paulrbarnard/LandyGauge/static/images/CompD.jpeg

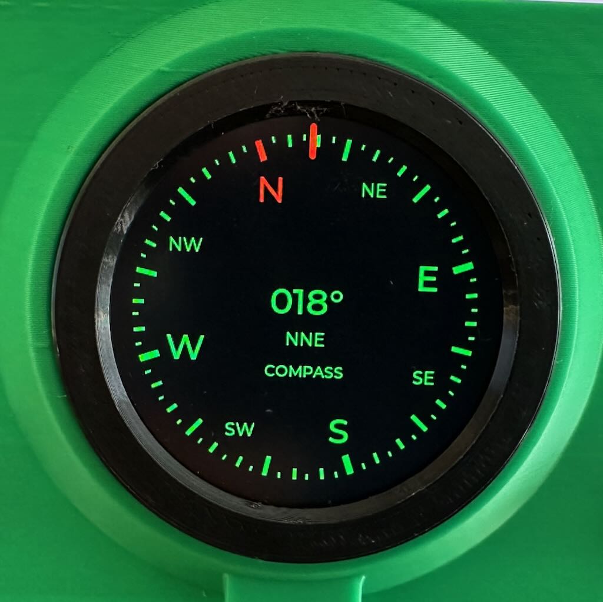
static/images/CompD.jpeg
