paulrbarnard/LandyGauge/static/images/Gauges.jpeg

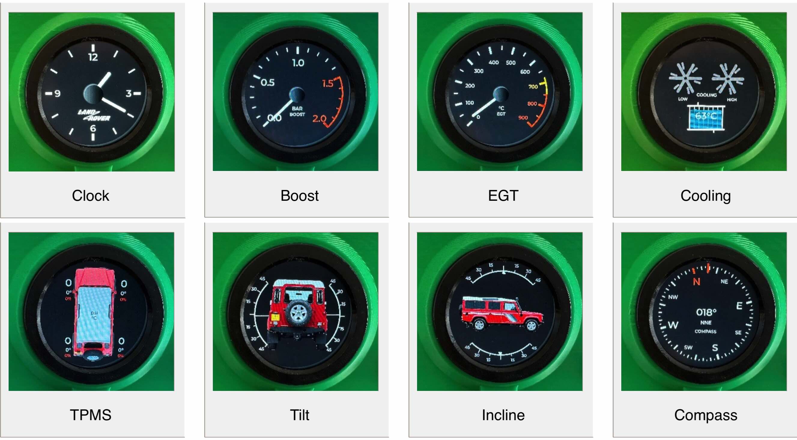
static/images/Gauges.jpeg
