paulrbarnard/LandyGauge/content/blog/_index.md

---
title: "Blog"
date: 2026-04-20
draft: false
ShowToc: false
---
