paulrbarnard/LandyGauge/static/images/Boost.jpeg

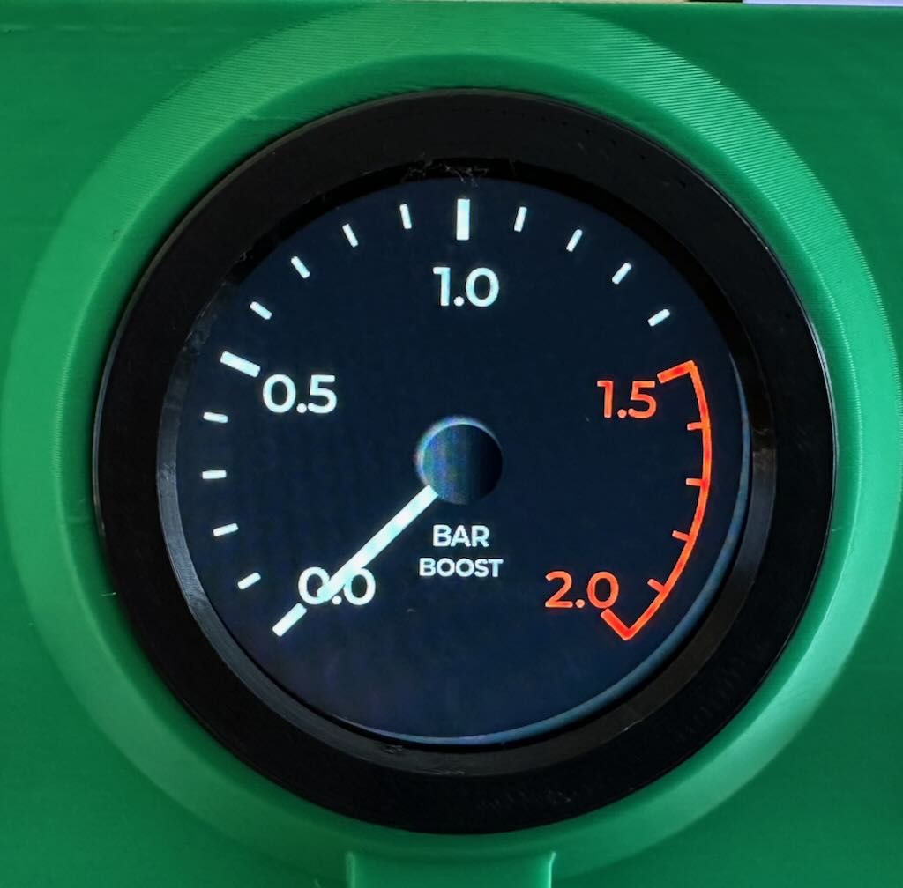
static/images/Boost.jpeg
