paulrbarnard/LandyGauge/static/images/BoostD.jpeg

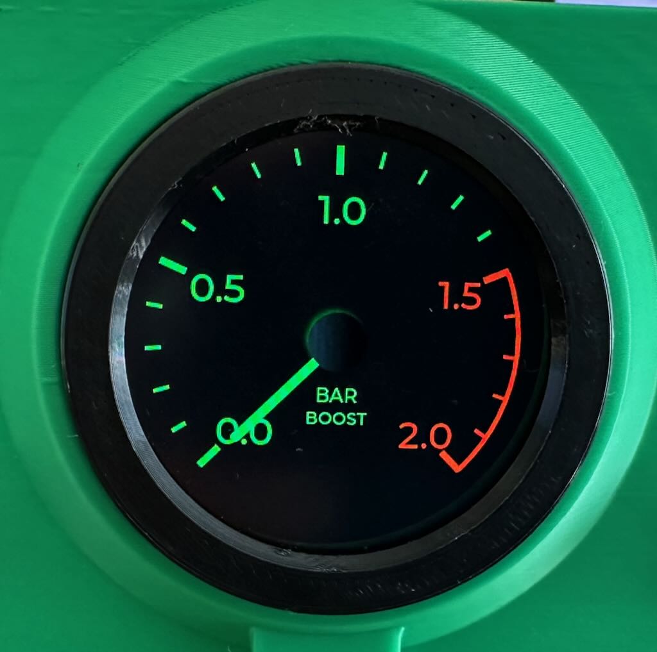
static/images/BoostD.jpeg
