paulrbarnard/LandyGauge/static/images/CAD.jpg

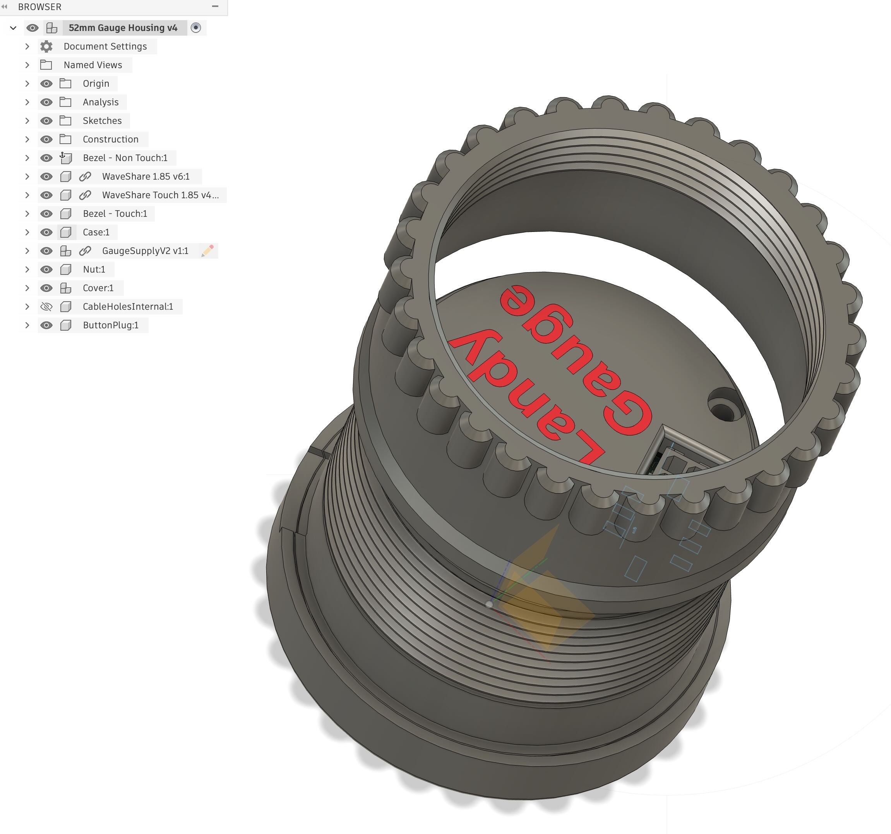
static/images/CAD.jpg
