paulrbarnard/LandyGauge/static/images/Clock.jpeg

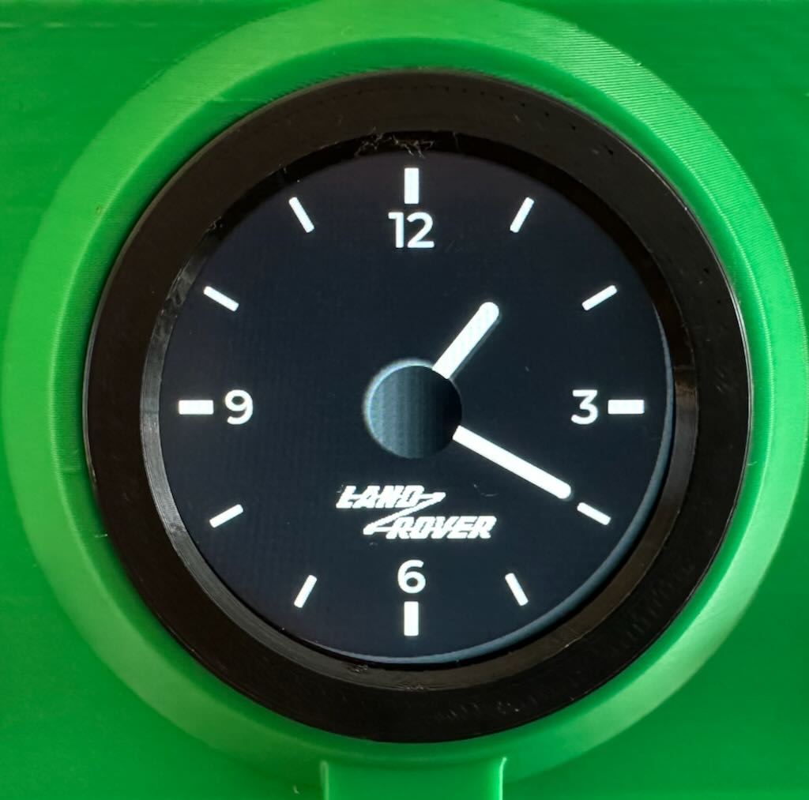
static/images/Clock.jpeg
