paulrbarnard/LandyGauge/static/images/ClockD.jpeg

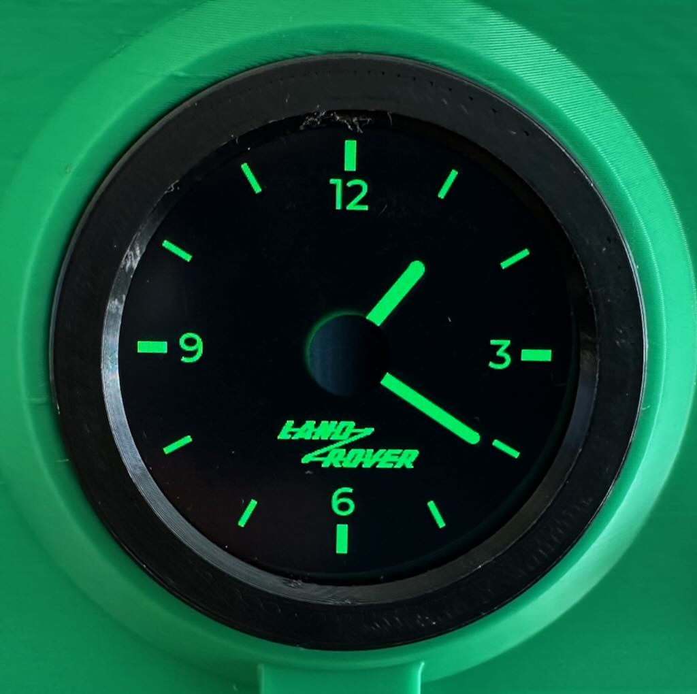
static/images/ClockD.jpeg
