paulrbarnard/LandyGauge/static/images/Comp.jpeg

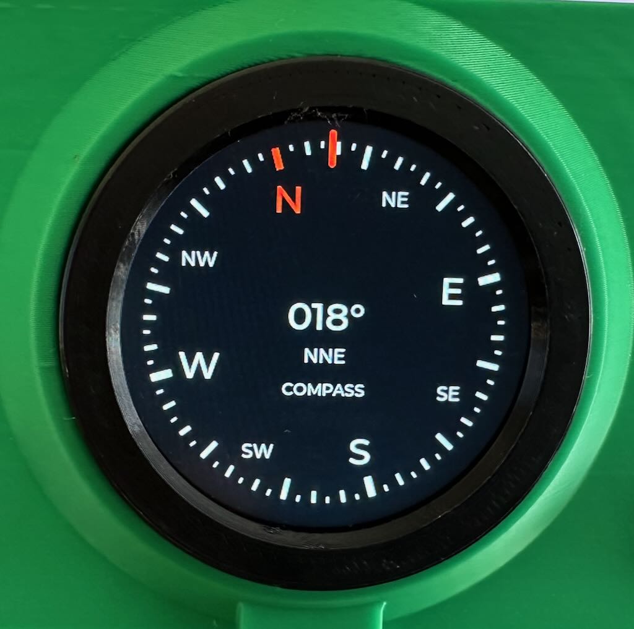
static/images/Comp.jpeg
