paulrbarnard/LandyGauge/static/images/Cool.jpeg

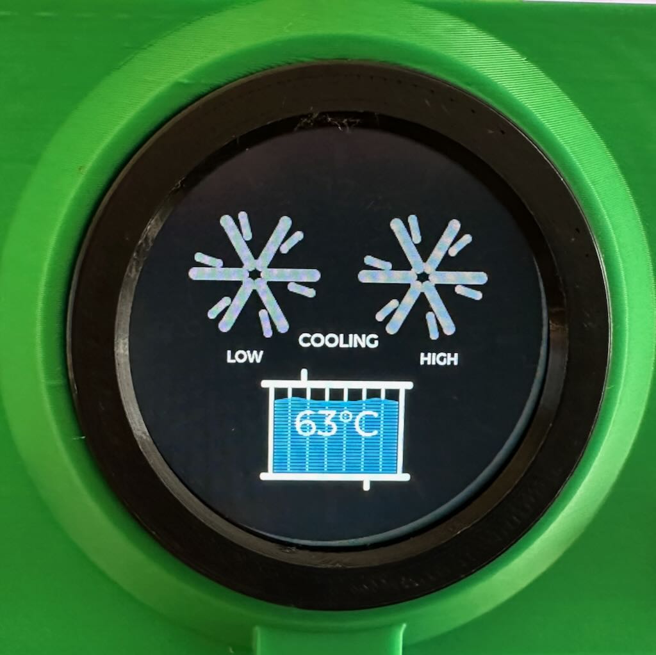
static/images/Cool.jpeg
