paulrbarnard/LandyGauge/static/images/CoolD.jpeg

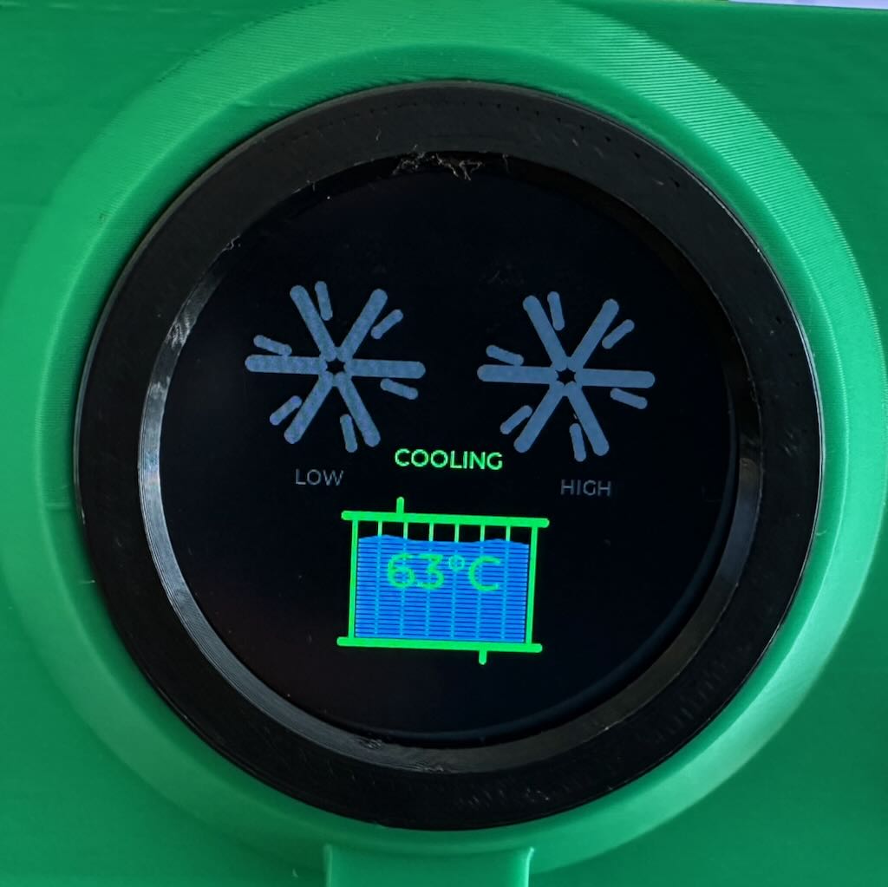
static/images/CoolD.jpeg
