paulrbarnard/LandyGauge/static/images/Dash.jpeg

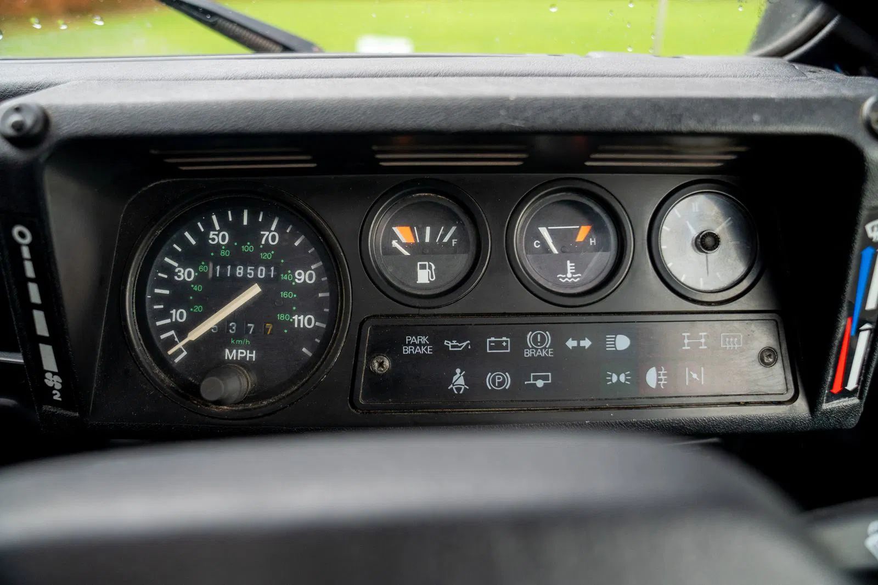
static/images/Dash.jpeg
