paulrbarnard/LandyGauge/static/images/EGT.jpeg

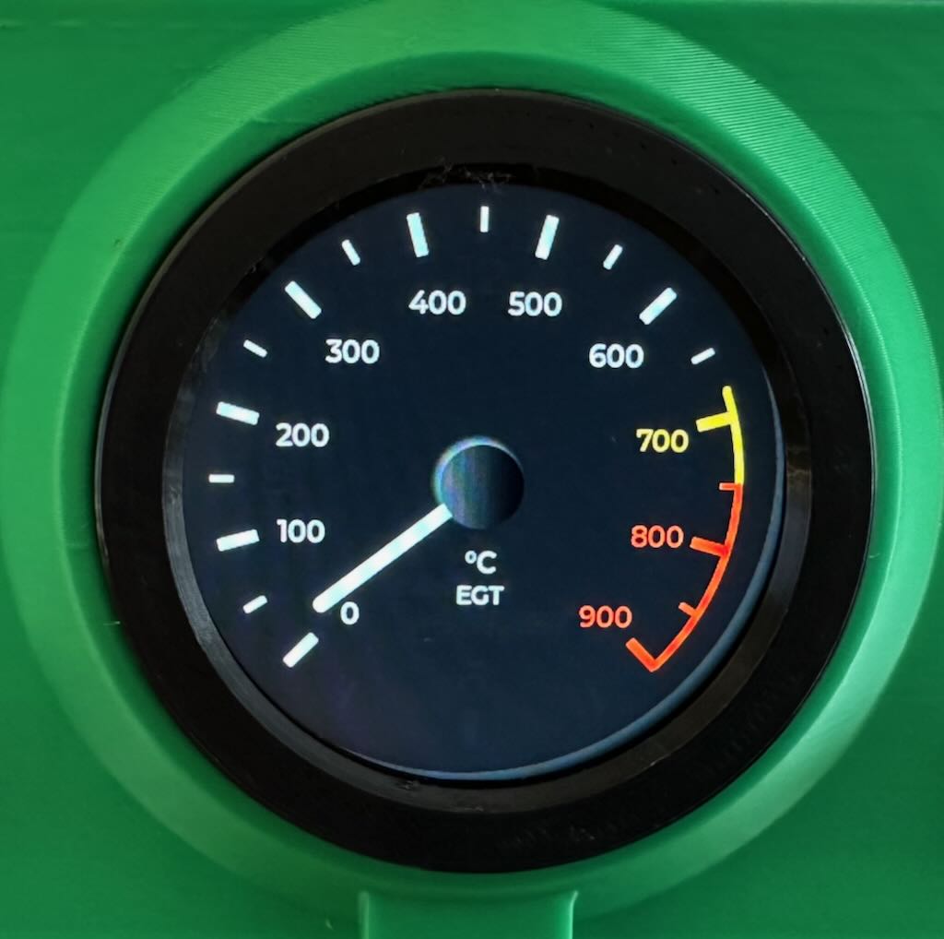
static/images/EGT.jpeg
