paulrbarnard/LandyGauge/static/images/EGTD.jpeg

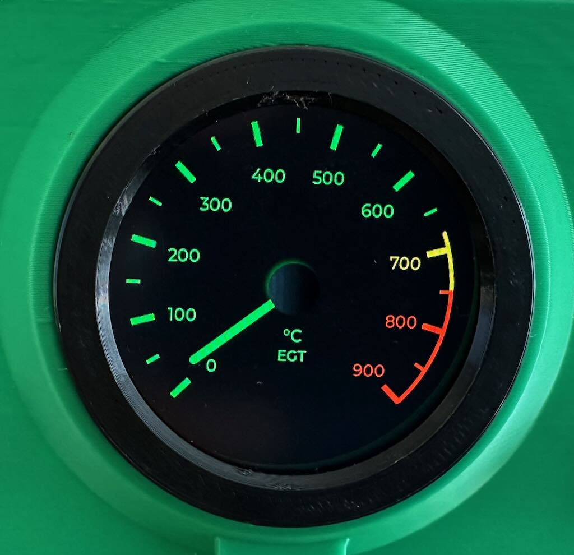
static/images/EGTD.jpeg
