paulrbarnard/LandyGauge/static/images/Incl.jpeg

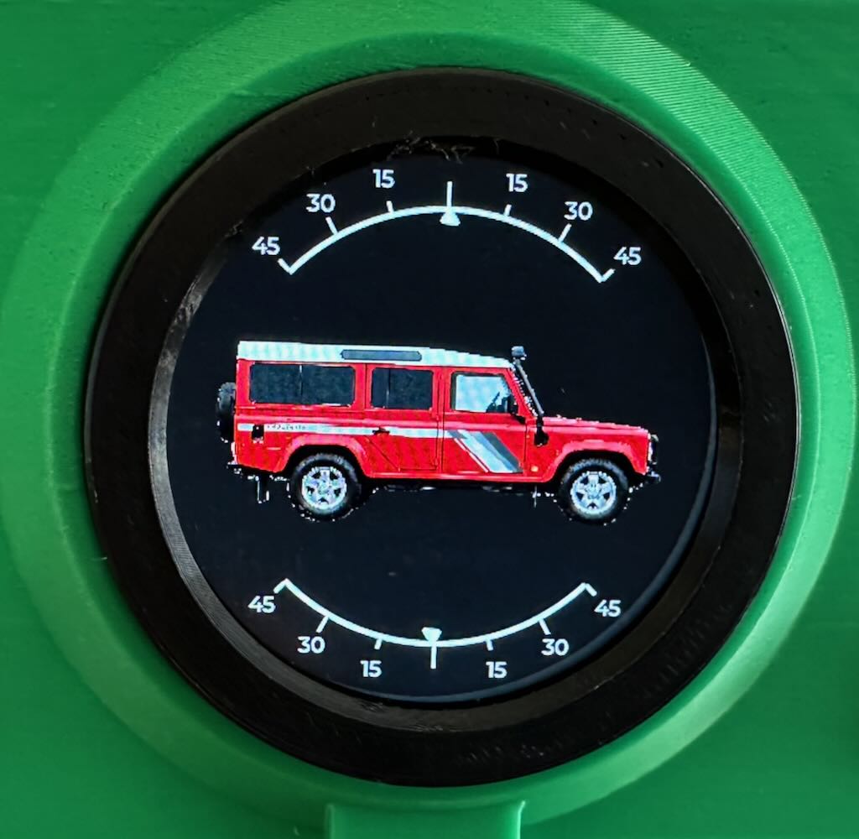
static/images/Incl.jpeg
