paulrbarnard/LandyGauge/static/images/InclD.jpeg

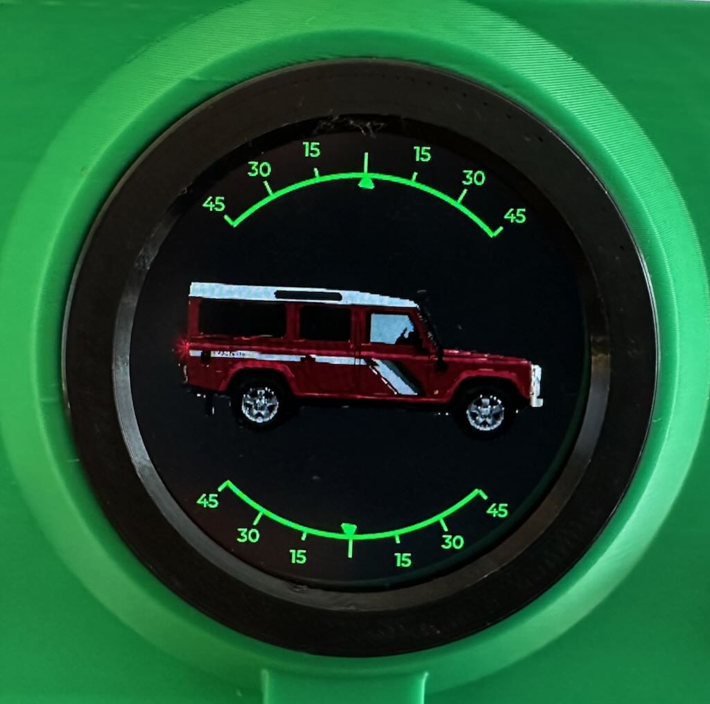
static/images/InclD.jpeg
