paulrbarnard/LandyGauge/static/images/LGCon.jpeg

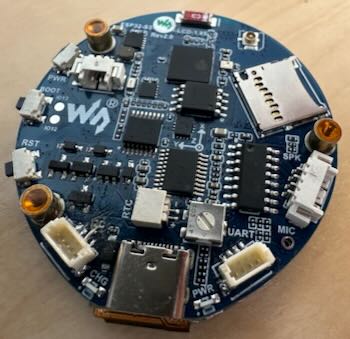
static/images/LGCon.jpeg
