paulrbarnard/LandyGauge/static/images/OrigClk.jpeg

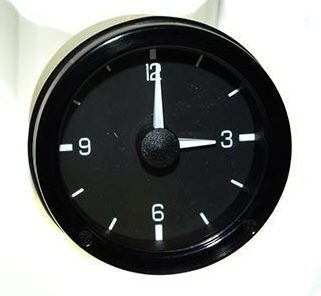
static/images/OrigClk.jpeg
