paulrbarnard/LandyGauge/static/images/RearView.jpeg

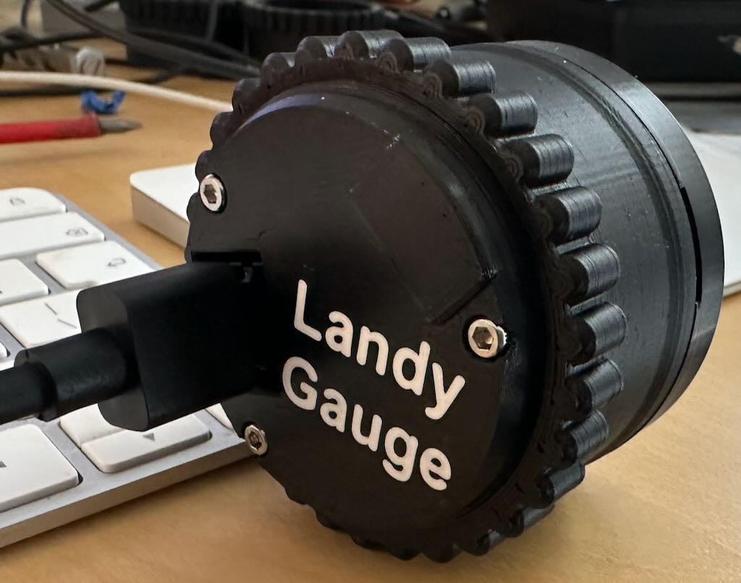
static/images/RearView.jpeg
