paulrbarnard/LandyGauge/static/images/Tilt.jpeg

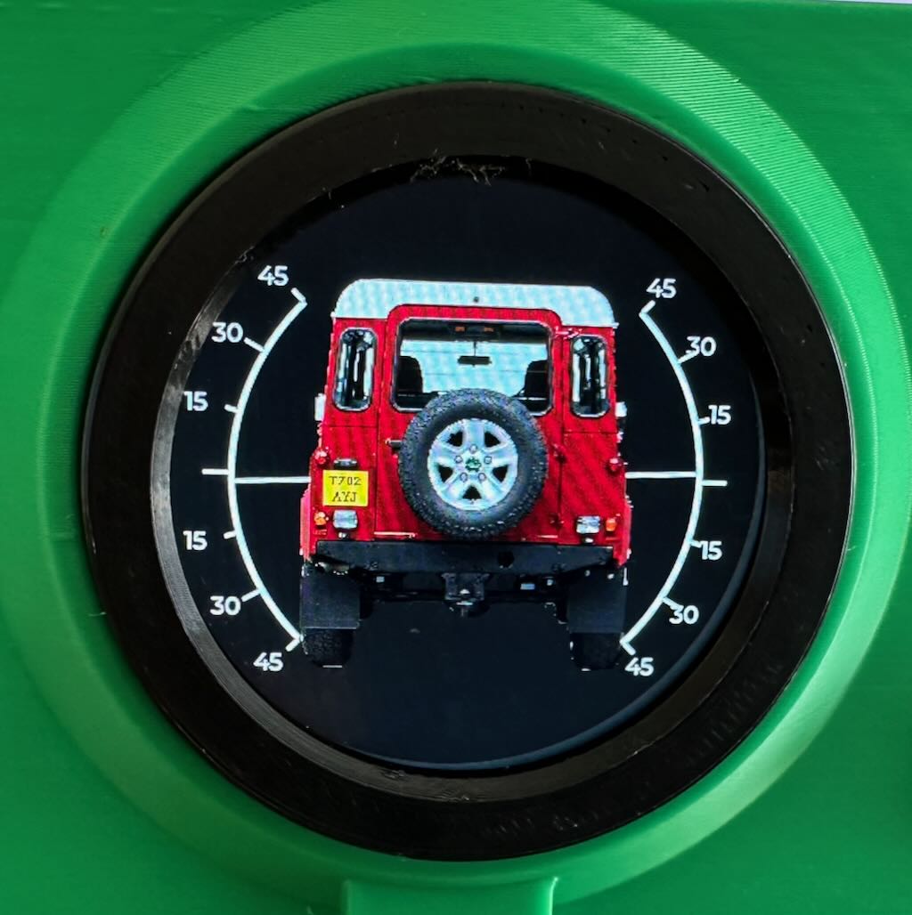
static/images/Tilt.jpeg
