paulrbarnard/LandyGauge/static/images/TiltD.jpeg

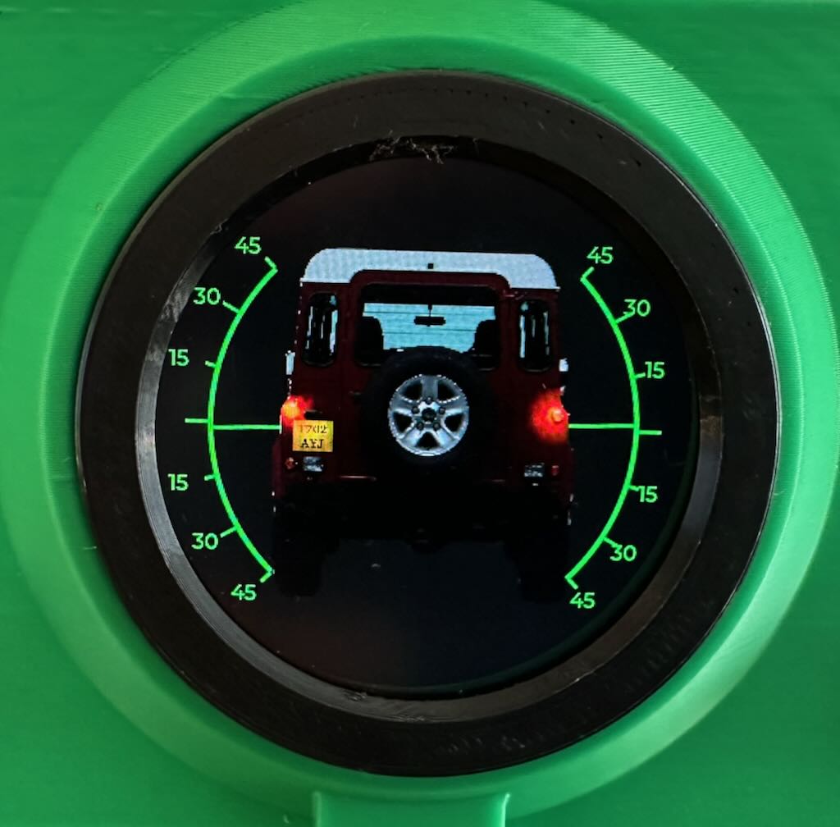
static/images/TiltD.jpeg
