paulrbarnard/LandyGauge/static/images/TPMS.jpeg

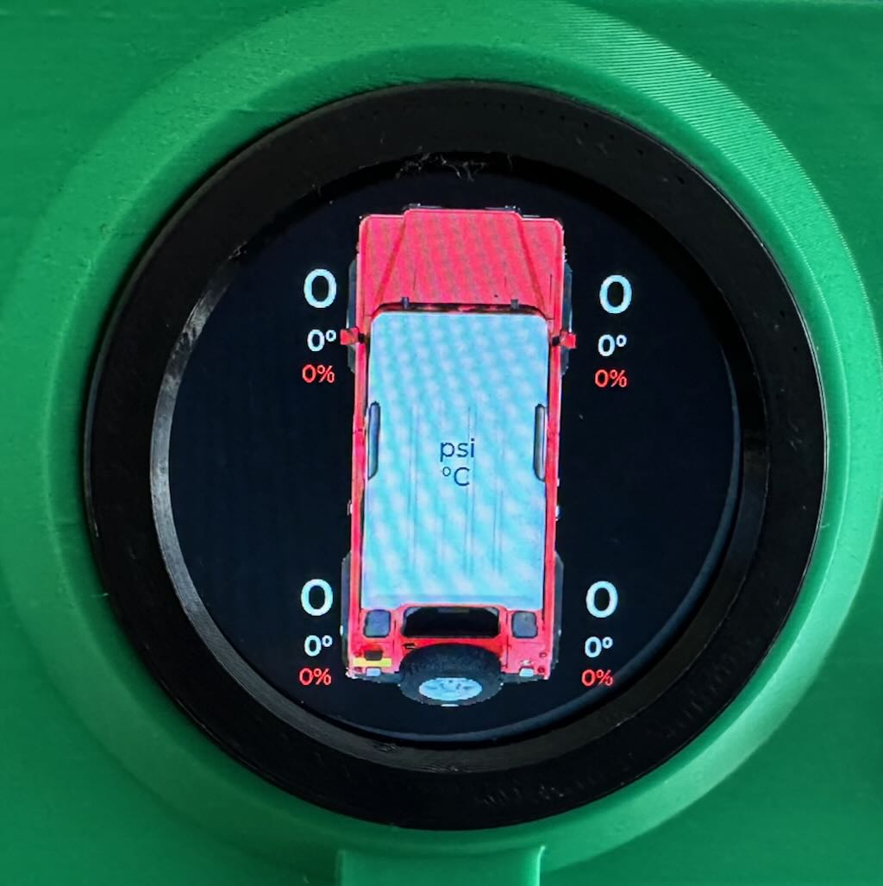
static/images/TPMS.jpeg
