paulrbarnard/LandyGauge/static/images/TPMSD.jpeg

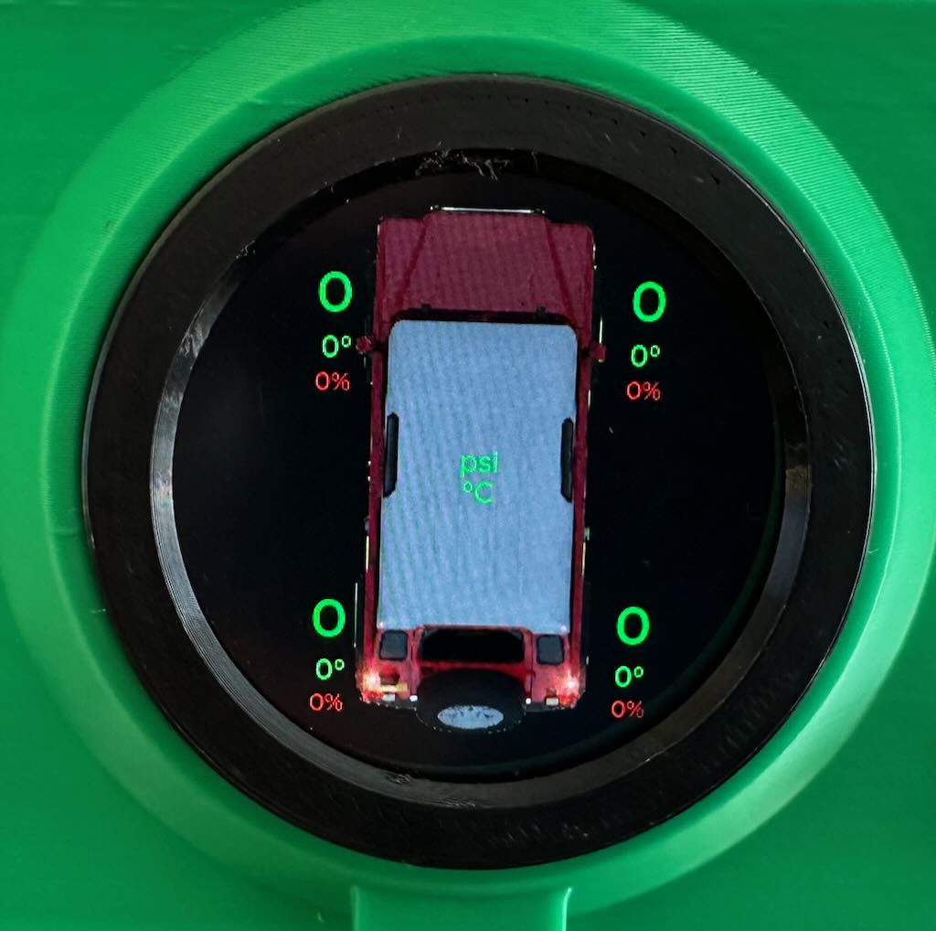
static/images/TPMSD.jpeg
