paulrbarnard/LandyGauge/static/images/WSCon.jpeg

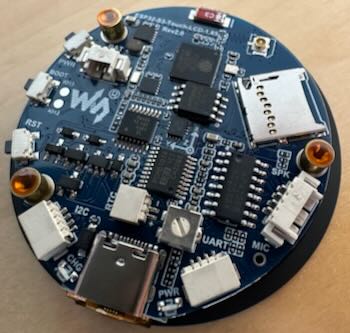
static/images/WSCon.jpeg
