paulrbarnard/LandyGauge/static/downloads/3d-models/expansion-box/BoardClamp.obj

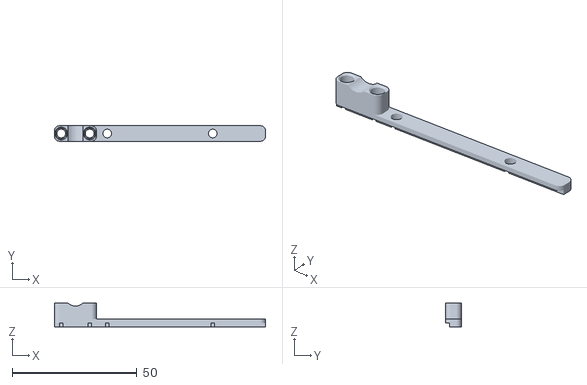
[picture p24: CAD file, 2026-04-22]
static/downloads/3d-models/expansion-box/BoardClamp.obj
84.5 x 6.25 x 9.60
