paulrbarnard/LandyGauge/static/downloads/3d-models/fan-relay-box-type1/gromit.obj

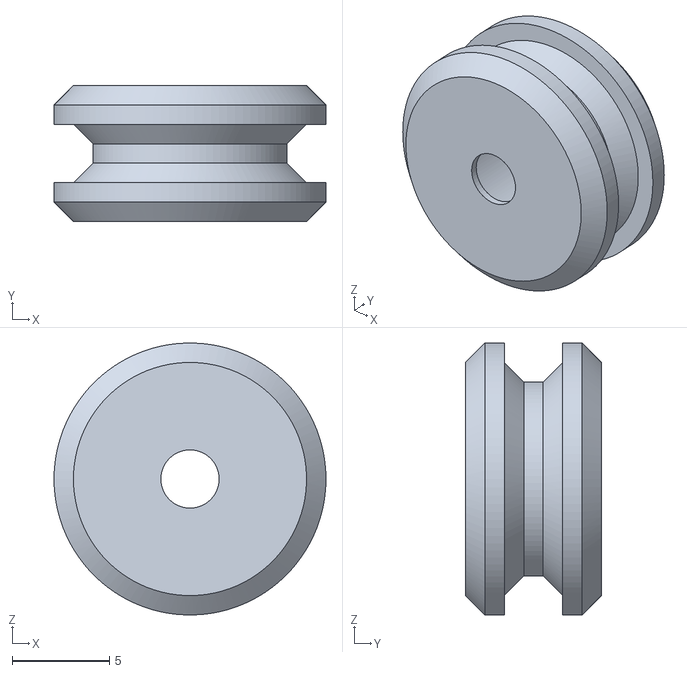
[picture p25: CAD file, 2026-04-22]
static/downloads/3d-models/fan-relay-box-type1/gromit.obj
14.0 x 7.00 x 14.0
