paulrbarnard/LandyGauge/static/downloads/3d-models/fan-relay-box-type2/Grommit.obj

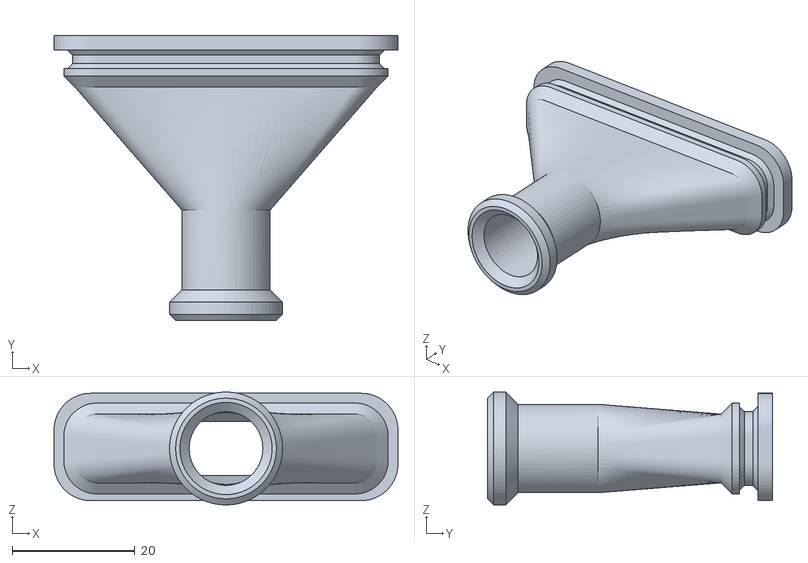
[picture p26: CAD file, 2026-04-22]
static/downloads/3d-models/fan-relay-box-type2/Grommit.obj
56.0 x 46.4 x 18.4
