paulrbarnard/LandyGauge/static/downloads/3d-models/gauge-housing/Cover.obj

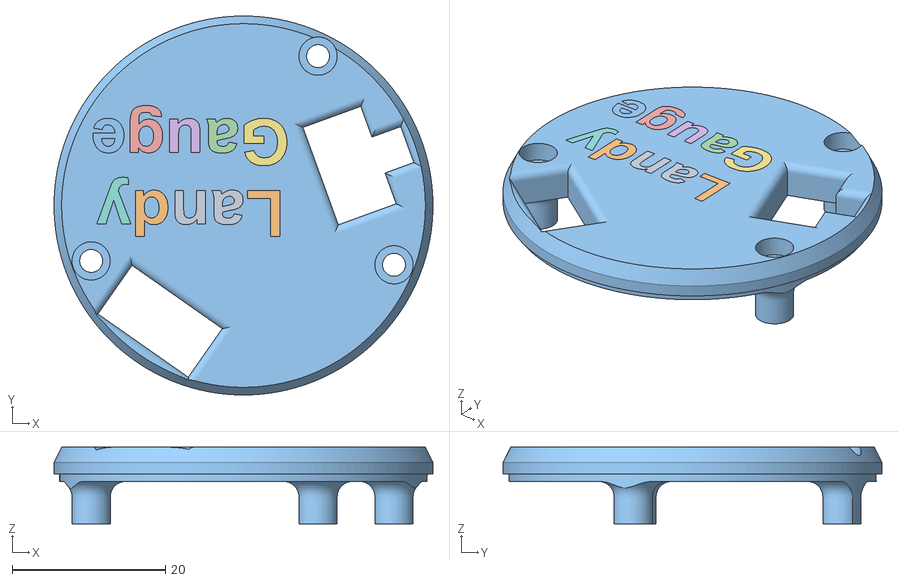
[picture p27: CAD file, 2026-04-20]
static/downloads/3d-models/gauge-housing/Cover.obj
49.5 x 49.5 x 10.1
Cap
