paulrbarnard/LandyGauge/static/downloads/pcb-fan-relay/LandyFan.step

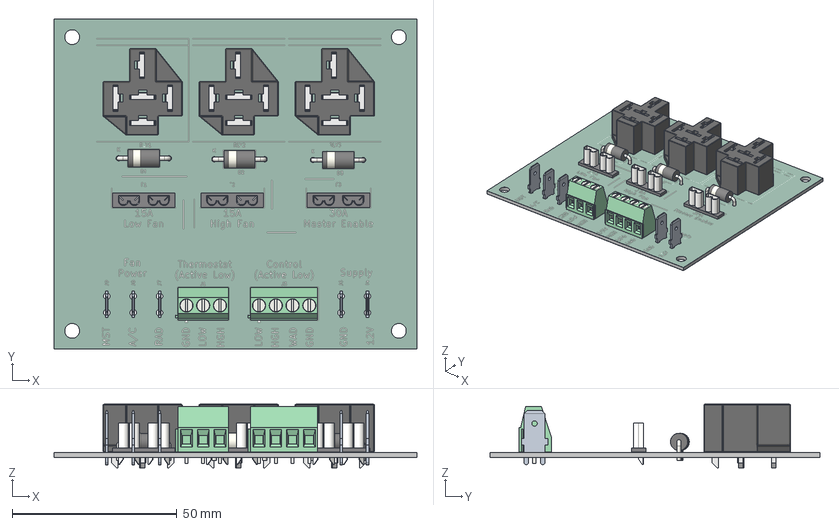
[picture p28: CAD file, 2026-04-20]
static/downloads/pcb-fan-relay/LandyFan.step
110.0 x 100.0 x 19.2 mm
Pins x 3
Spade x 5
pins x 3
TerminalBlock_Phoenix_MKDS-1,5-4-5.08_1x04_P5.08mm_Horizontal
TerminalBlock_Phoenix_MKDS-1,5-3-5.08_1x03_P5.08mm_Horizontal
D_DO-201AD_P15.24mm_Horizontal x 3
LandyFan_silkscreen
LandyFan_soldermask x 2
LandyFan_PCB
