paulrbarnard/LandyGauge/static/downloads/pcb-gauge-supply/GaugeSupply.step

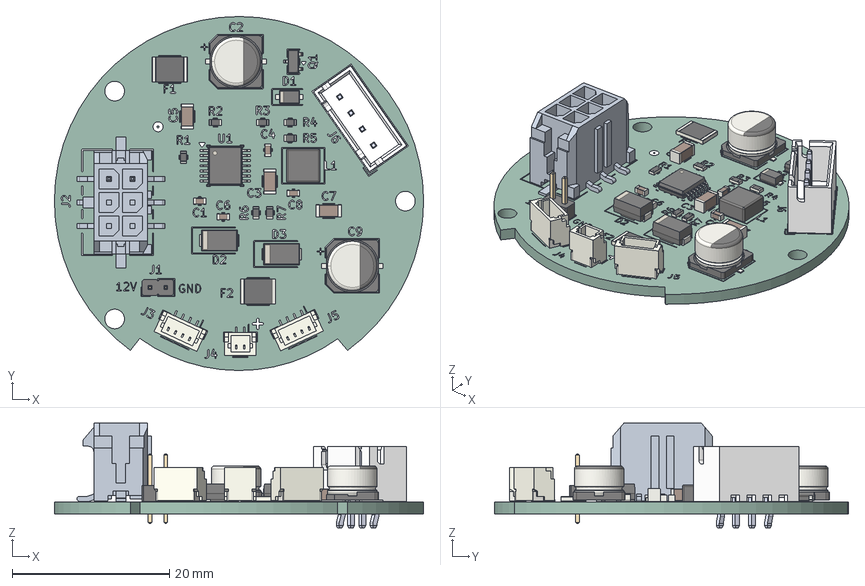
[picture p29: CAD file, 2026-04-20]
static/downloads/pcb-gauge-supply/GaugeSupply.step
47.0 x 45.1 x 13.4 mm
R_0603_1608Metric x 7
C_0603_1608Metric x 4
PinHeader_1x02_P2.00mm_Vertical
BxB-XH-A_04
R_1812_4532Metric x 2
D_SOD-123F
Texas_HTSSOP-14-1EP_4.4x5mm_P0.65mm_EP3.4x5mm_Mask3.155x3.255mm
CP_Elec_6.3x4.5 x 2
JST_SH_BM04B-SRSS-TB_1x04-1MP_P1.00mm_Vertical x 2
C_1206_3216Metric x 3
SOT-23
D_SMA x 2
L_Coilcraft_XAL4020-XXX
JST_SH_BM02B-SRSS-TB_1x02-1MP_P1.00mm_Vertical
GaugeSupply_silkscreen x 2
GaugeSupply_PCB
