paulrbarnard/LandyGauge/static/downloads/3d-models/expansion-box/lockTab.obj

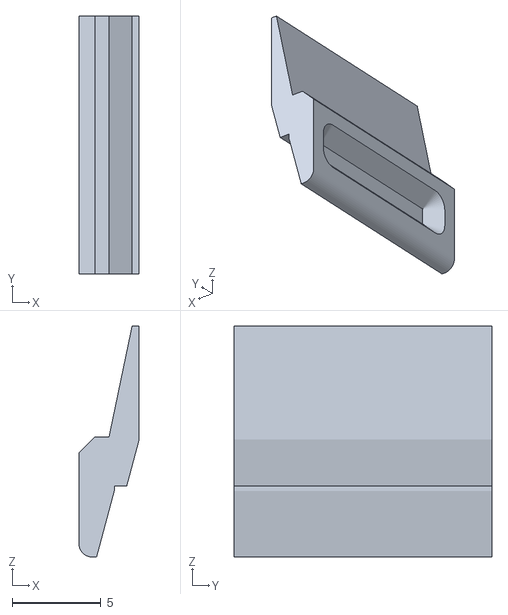
[picture p30: CAD file, 2026-04-22]
static/downloads/3d-models/expansion-box/lockTab.obj
3.40 x 14.5 x 13.0
