paulrbarnard/LandyGauge/static/downloads/3d-models/fan-relay-box-type1/lid.obj

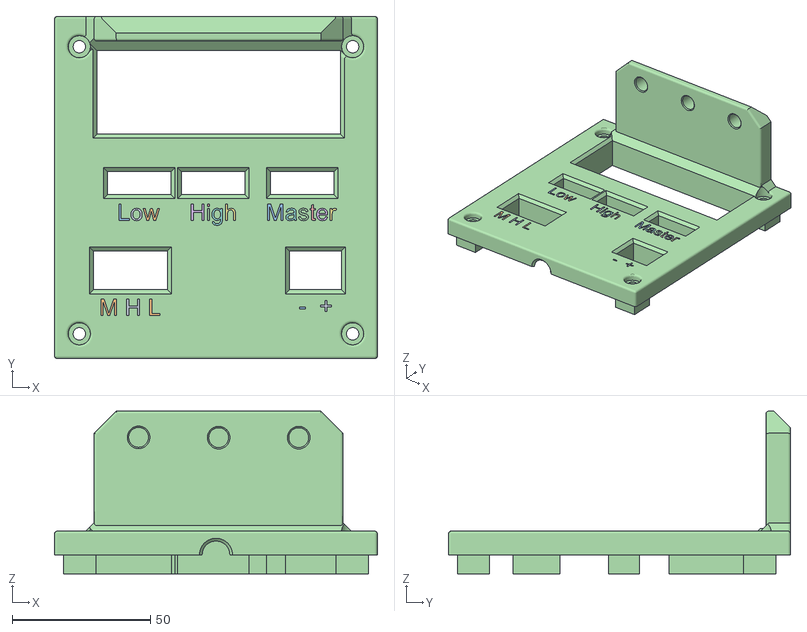
[picture p31: CAD file, 2026-04-22]
static/downloads/3d-models/fan-relay-box-type1/lid.obj
117.0 x 124.0 x 58.9
