paulrbarnard/LandyGauge/static/downloads/3d-models/fan-relay-box-type2/Base.obj

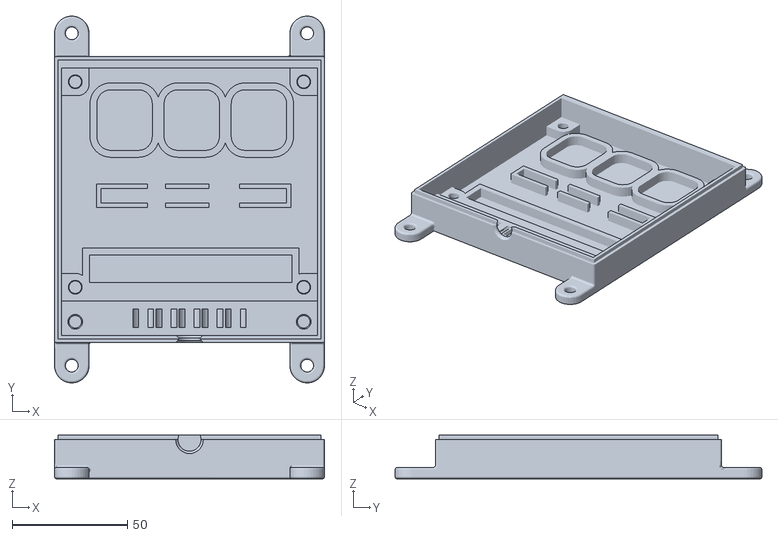
[picture p32: CAD file, 2026-04-22]
static/downloads/3d-models/fan-relay-box-type2/Base.obj
117.0 x 159.0 x 19.0
