paulrbarnard/LandyGauge/static/downloads/3d-models/expansion-box/lid.obj

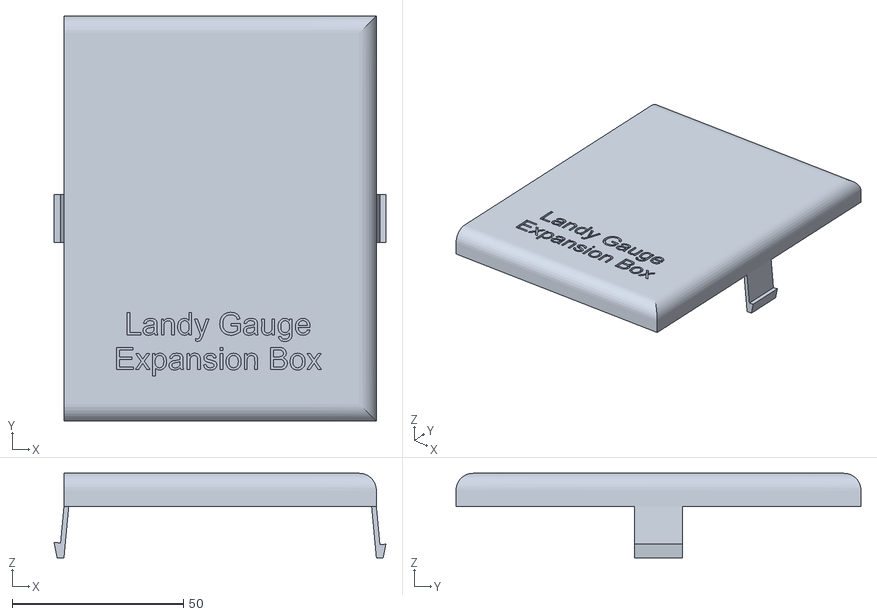
[picture p33: CAD file, 2026-04-22]
static/downloads/3d-models/expansion-box/lid.obj
96.8 x 118.1 x 24.6
