paulrbarnard/LandyGauge/static/downloads/3d-models/fan-relay-box-type2/Gaskit.obj

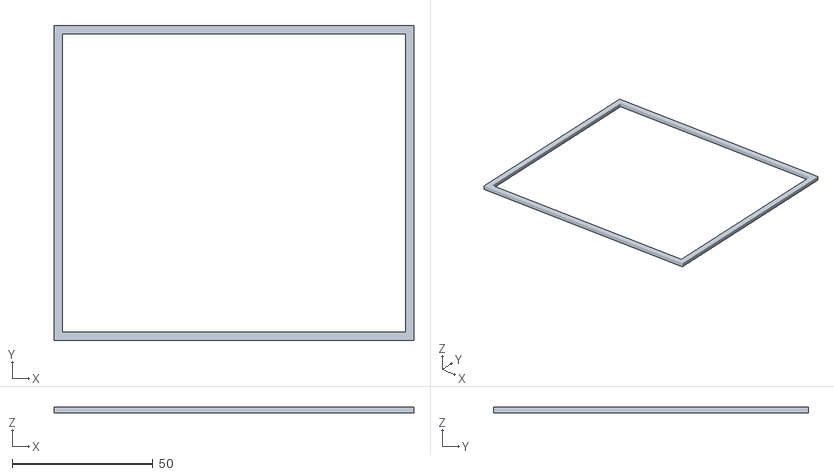
[picture p34: CAD file, 2026-04-22]
static/downloads/3d-models/fan-relay-box-type2/Gaskit.obj
128.0 x 112.0 x 2.00
