paulrbarnard/LandyGauge/static/downloads/3d-models/gauge-housing/Case.obj

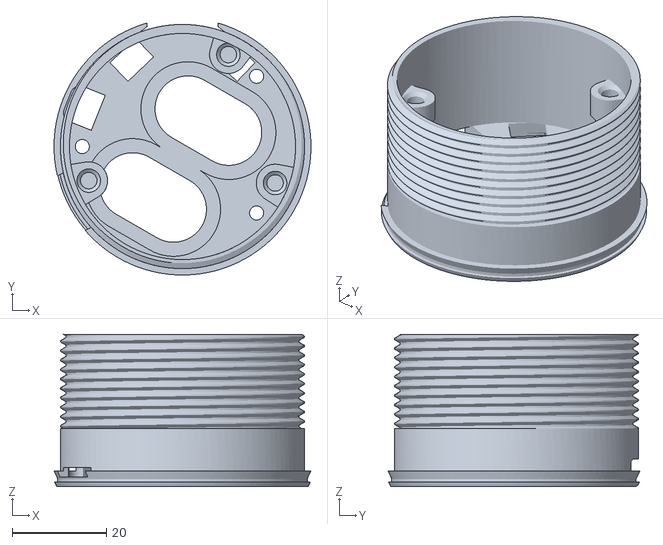
[picture p35: CAD file, 2026-04-20]
static/downloads/3d-models/gauge-housing/Case.obj
54.6 x 53.5 x 32.4
