paulrbarnard/LandyGauge/static/downloads/3d-models/expansion-box/CableClamp.obj

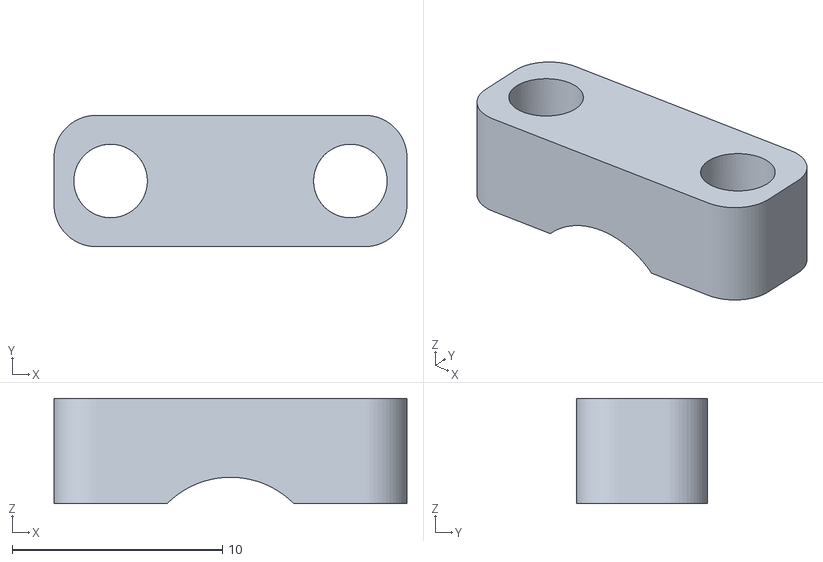
[picture p36: CAD file, 2026-04-22]
static/downloads/3d-models/expansion-box/CableClamp.obj
16.8 x 6.25 x 5.00
