paulrbarnard/LandyGauge/static/downloads/3d-models/gauge-housing/ButtonPlug.obj

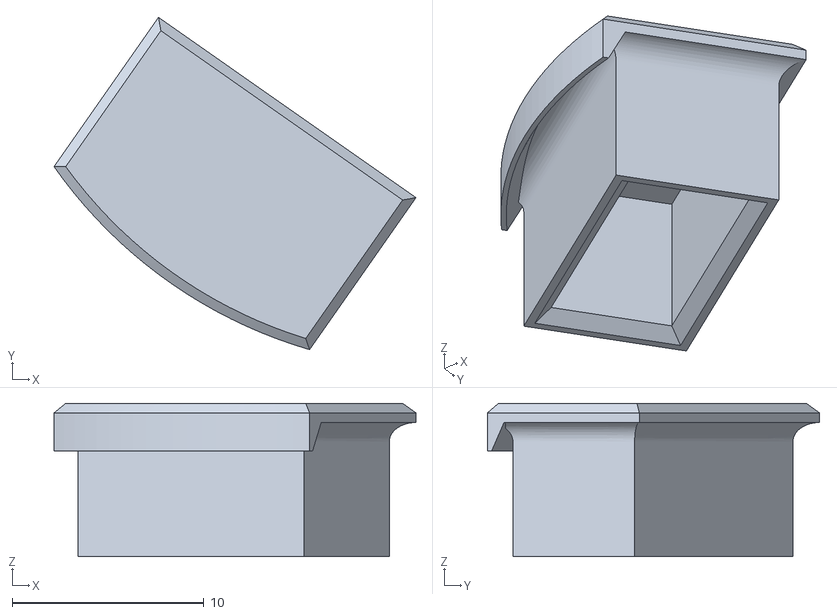
[picture p37: CAD file, 2026-04-20]
static/downloads/3d-models/gauge-housing/ButtonPlug.obj
18.9 x 17.3 x 8.00
