paulrbarnard/LandyGauge/static/downloads/3d-models/expansion-box/Base.obj

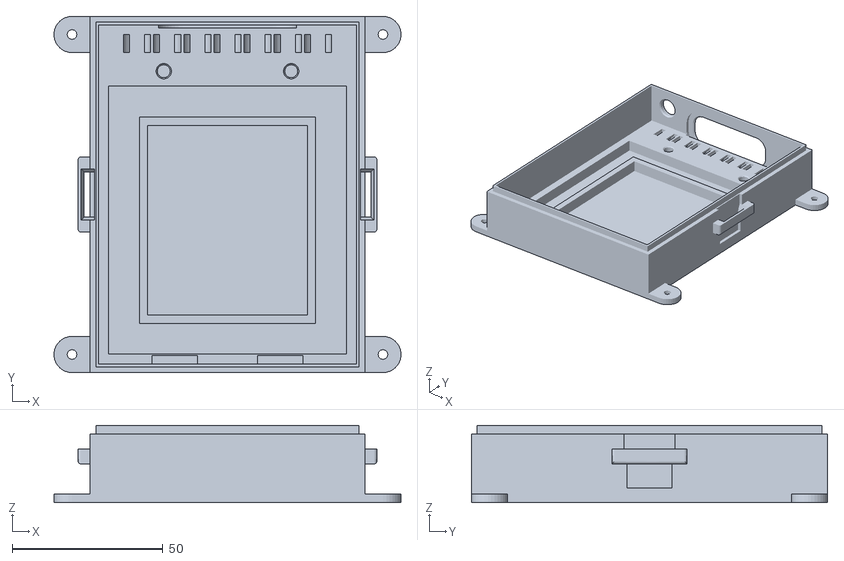
[picture p38: CAD file, 2026-04-22]
static/downloads/3d-models/expansion-box/Base.obj
115.0 x 118.1 x 25.6
