paulrbarnard/LandyGauge/static/downloads/3d-models/fan-relay-box-type2/lid.obj

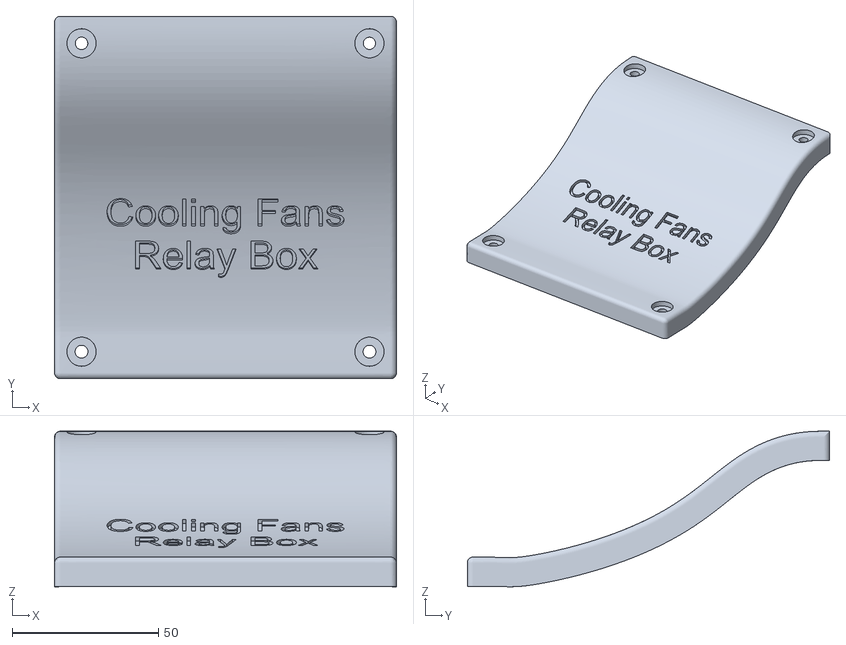
[picture p39: CAD file, 2026-04-22]
static/downloads/3d-models/fan-relay-box-type2/lid.obj
117.0 x 124.0 x 53.2
