paulrbarnard/LandyGauge/static/downloads/3d-models/gauge-housing/Bezel - Non Touch.obj

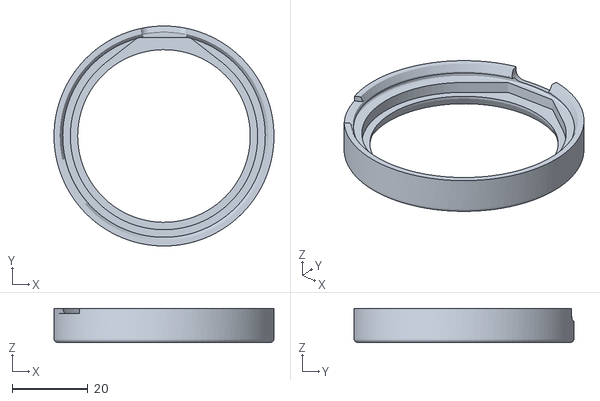
[picture p40: CAD file, 2026-04-20]
static/downloads/3d-models/gauge-housing/Bezel - Non Touch.obj
58.0 x 58.0 x 9.00
