paulrbarnard/LandyGauge/static/downloads/3d-models/expansion-box/grommit.obj

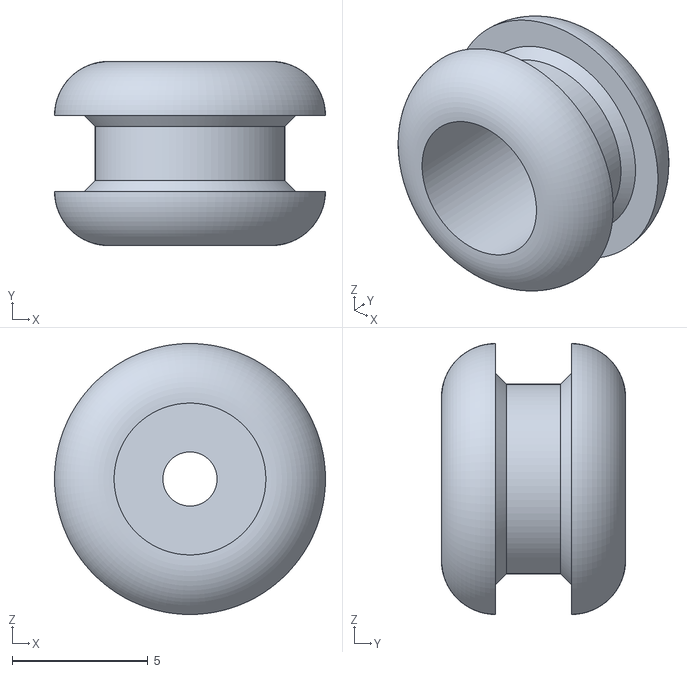
[picture p41: CAD file, 2026-04-22]
static/downloads/3d-models/expansion-box/grommit.obj
10.0 x 6.80 x 10.0
