paulrbarnard/LandyGauge/static/downloads/3d-models/gauge-housing/Bezel - Touch.obj

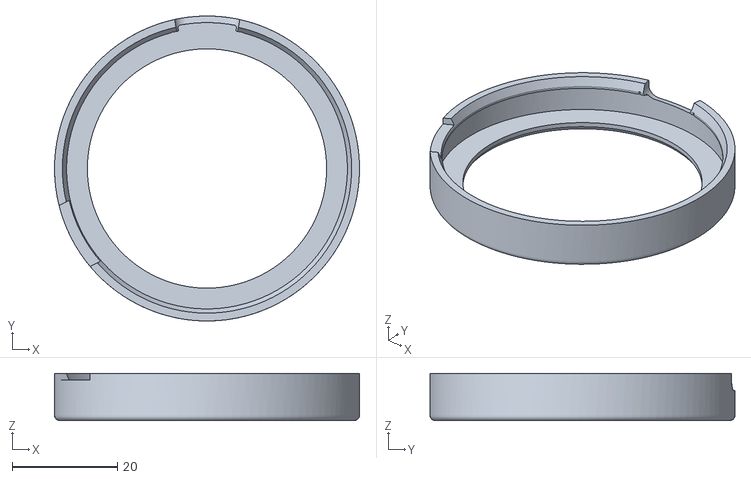
[picture p42: CAD file, 2026-04-20]
static/downloads/3d-models/gauge-housing/Bezel - Touch.obj
58.0 x 58.0 x 9.00
