paulrbarnard/LandyGauge/static/downloads/3d-models/expansion-box/wireGuide.obj

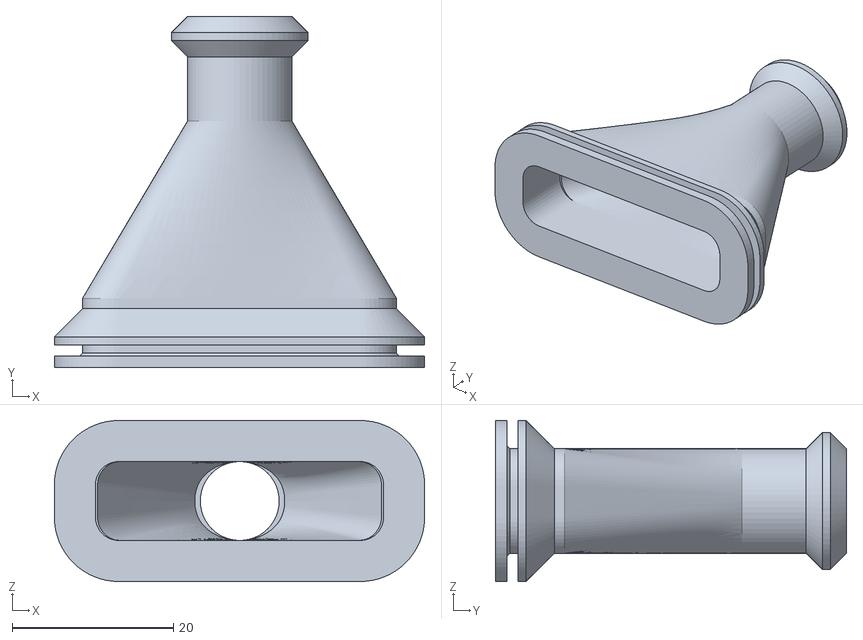
[picture p43: CAD file, 2026-04-22]
static/downloads/3d-models/expansion-box/wireGuide.obj
46.0 x 43.6 x 20.0
