paulrbarnard/LandyGauge/(list of files, cad)

Other CAD files:
static/downloads/3d-models/fan-relay-box-type1/FanRelayBoxType1.f3z
static/downloads/3d-models/fan-relay-box-type2/FanBoxGaskit.f3d
static/downloads/3d-models/fan-relay-box-type2/lid washer.obj
static/downloads/3d-models/gauge-housing/Nut.obj
