paulrbarnard/LandyGauge/static/downloads/wiring/Gauge Wiring.pdf

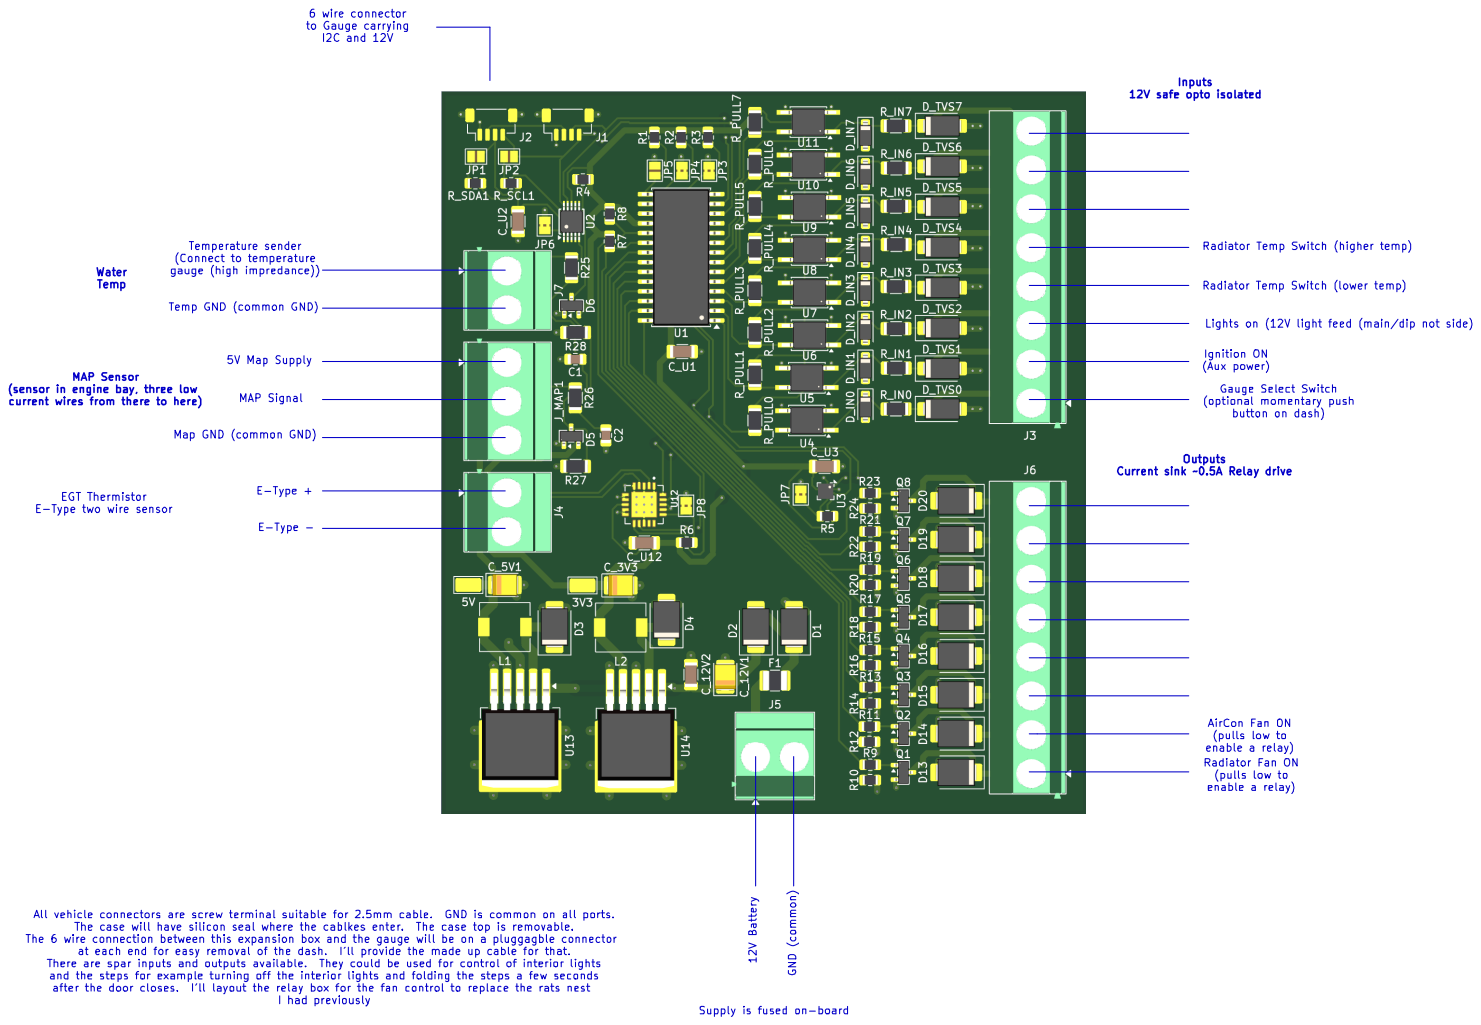
[picture p44: page 1]
