paulrbarnard/LandyGauge/static/downloads/pcb-expansion-board/ExpansionBoard.pdf

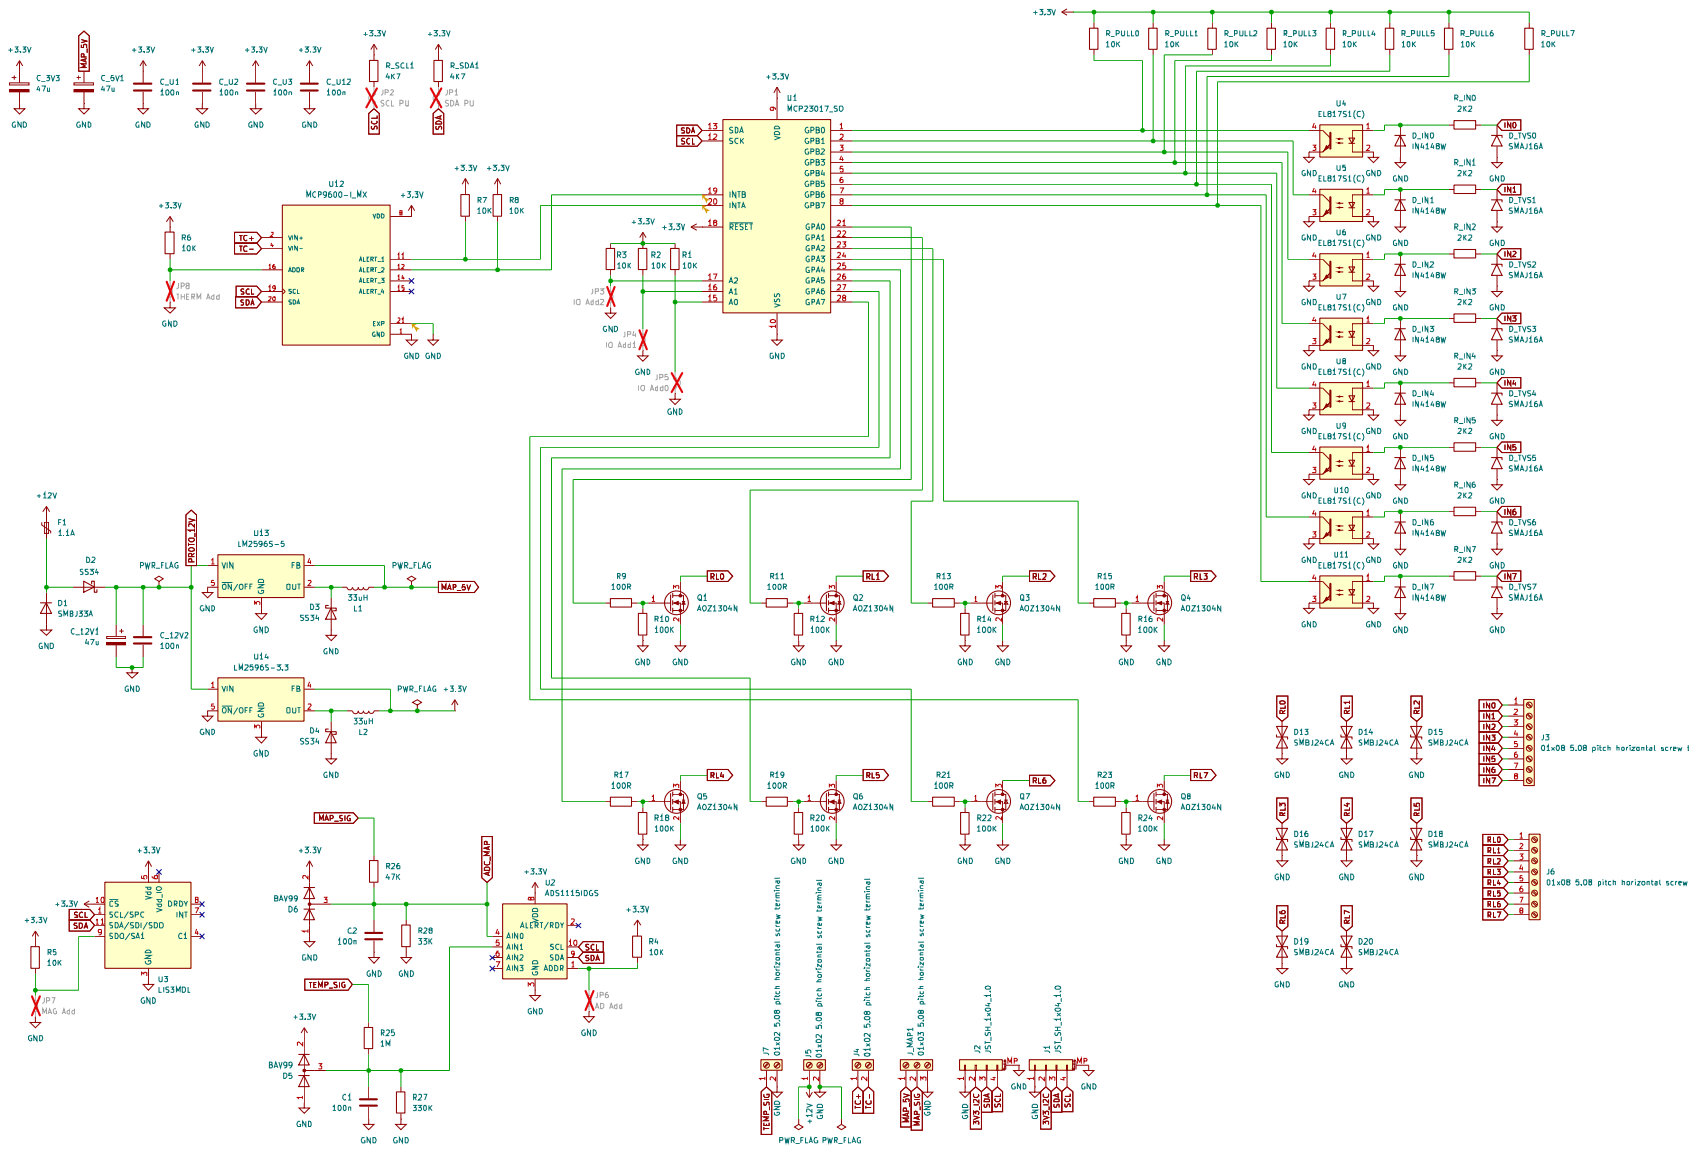
[picture p45: page 1]
