paulrbarnard/LandyGauge/static/downloads/pcb-gauge-supply/GaugeSupply.kicad_pcb

## KiCad design static/downloads/pcb-gauge-supply/GaugeSupply.kicad_pcb (2026-04-20)

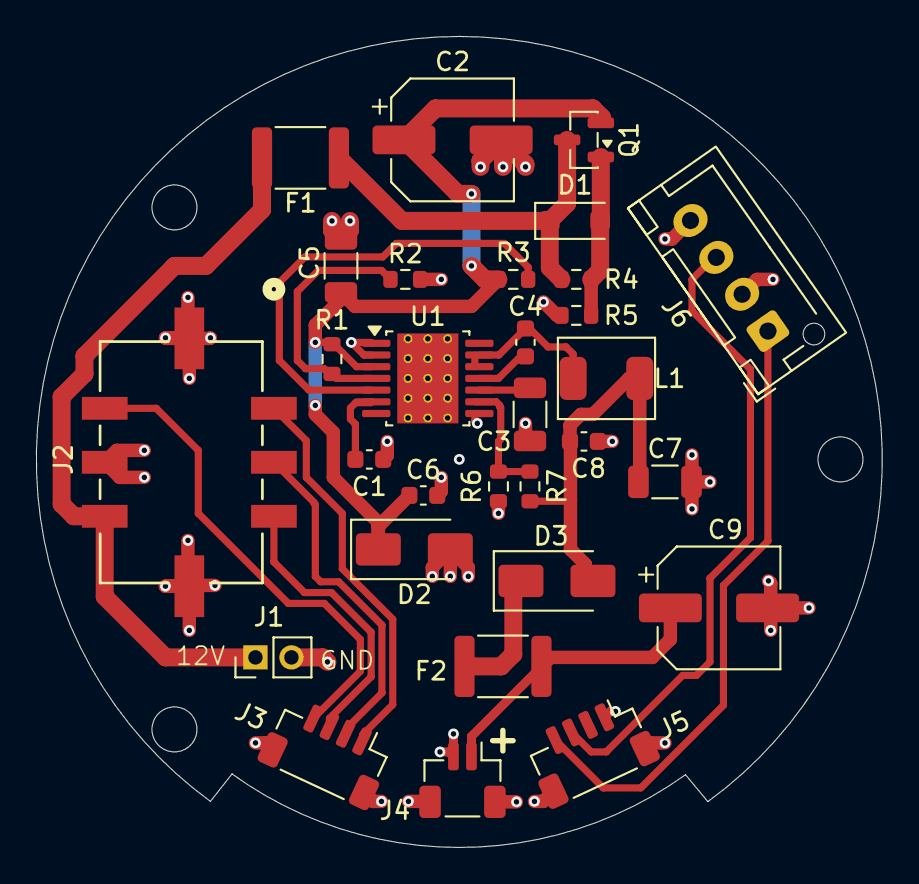
[picture p46: board GaugeSupply.kicad_pcb from above]

Board: 2 copper layers, 47.0 x 45.1 mm, 30 parts (0 on the bottom side), 21 nets.

Parts:
C1, C4: 10n; C_0603_1608Metric
C2, C9: 47u; CP_Elec_6.3x4.5
C3, C5: 1u; C_1206_3216Metric
C6, C8: 0.1u; C_0603_1608Metric
C7: 22u X7R; C_1206_3216Metric
D1: BZT52B12; D_SOD-123F
D2: SMBJ58A; D_SMA
D3: SS34; D_SMA
F1, F2: MF-MSMF110-2; Fuse_1812_4532Metric
J1: 12V Supply; PinHeader_1x02_P2.00mm_Vertical
J2: Molex to expansion; CONN_SD-43045-007_06_MOL
J3: i2C; JST_SH_BM04B-SRSS-TB_1x04-1MP_P1.00mm_Vertical
J4: 5VSupply; JST_SH_BM02B-SRSS-TB_1x02-1MP_P1.00mm_Vertical
J5: IO; JST_SH_BM04B-SRSS-TB_1x04-1MP_P1.00mm_Vertical
J6: Buttons; JST_XH_B4B-XH-AM_1x04_P2.50mm_Vertical
L1: 10uH; L_Coilcraft_XAL4020-XXX
Q1: AO3401A; SOT-23
R1: 499k; R_0603_1608Metric
R2, R3, R4, R5: 100k; R_0603_1608Metric
R6: 22.1k; R_0603_1608Metric
R7: 33k; R_0603_1608Metric
U1: LM5161PWP; Texas_HTSSOP-14-1EP_4.4x5mm_P0.65mm_EP3.4x5mm_Mask3.155x3.2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

Connections:
5VSupply: C9.1, F2.1, J4.1
5V_OR: D3.1 (K), F2.2
+12V: F1.1, J1.1, J2.6
GND: C1.2, C2.2, C3.2, C5.2, C6.2, C7.2, C8.2, C9.2, D2.2 (A2), J1.2, J2.5, J2.7, J2.8, J3.MP, J4.2, J4.MP, J5.1, J5.MP, J6.2, J6.4, R2.2, R5.2, R6.2, U1.1 (AGND), U1.2 (PGND), U1.8 (FPWM), U1.15 (AGND)
unnamed: D1.2 (A), Q1.1 (G), R4.2, R5.1
unnamed: C7.1, C8.1, D3.2 (A), L1.2, R7.1
unnamed: J2.1, J3.1
unnamed: J2.2, J3.2
unnamed: J2.3, J3.3
unnamed: J2.4, J3.4
unnamed: C4.2, U1.11 (BST)
unnamed: R1.2, R2.1, U1.4 (EN/UVLO)
unnamed: R6.1, R7.2, U1.9 (FB)
unnamed: R3.2, U1.5 (RON)
unnamed: C1.1, U1.6 (SS)
unnamed: C3.1, U1.10 (VCC)
Next: J5.4, J6.1
Prev: J5.3, J6.3
SW_Node: C4.1, L1.1, U1.12 (SW), U1.13 (SW)
Vin_Fused: D1.1 (K), F1.2, Q1.3 (D), R4.1
Vin_Prot: C2.1, C5.1, C6.1, D2.1 (A1), Q1.2 (S), R1.1, R3.1, U1.3 (VIN)
