paulrbarnard/LandyGauge/static/downloads/pcb-expansion-board/LandyGauge.kicad_pcb

## KiCad design static/downloads/pcb-expansion-board/LandyGauge.kicad_pcb (2026-04-20)

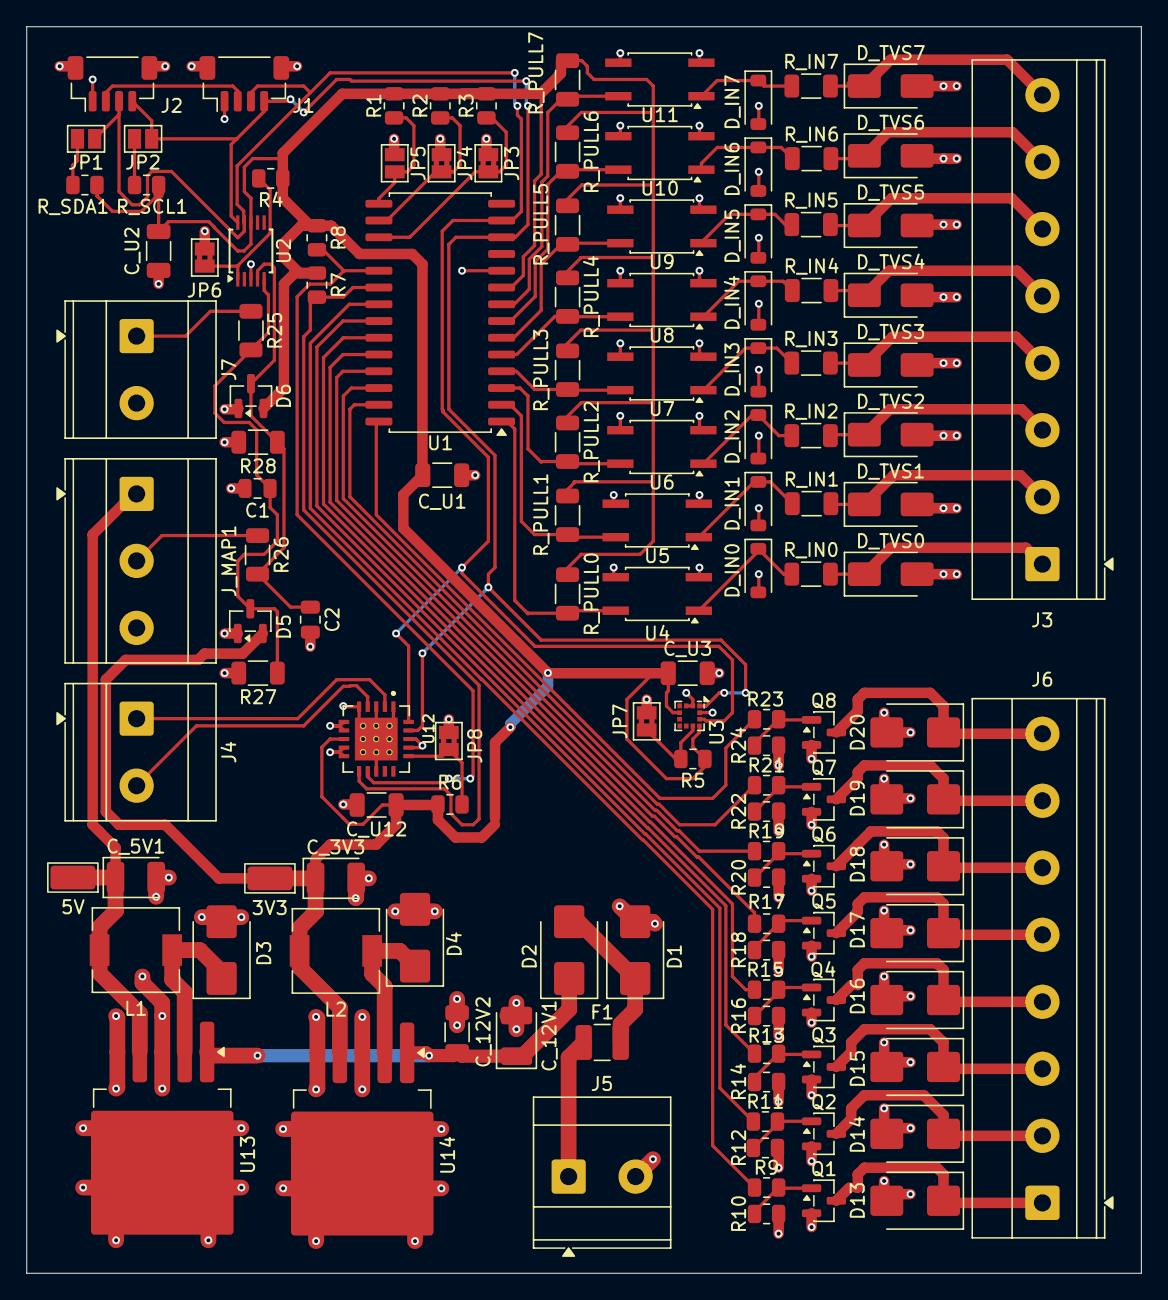
[picture p47: board LandyGauge.kicad_pcb from above]

Board: 2 copper layers, 84.5 x 94.5 mm, 129 parts (0 on the bottom side), 75 nets.

Parts:
3V3, 5V: TestPoint_Keystone_5015_Micro_Mini
C1, C2: 100n; C_0805_2012Metric
C_3V3, C_5V1, C_12V1: 47u; CP_EIA-3528-21_Kemet-B
C_12V2: 100n; C_1206_3216Metric
C_U1, C_U2, C_U3, C_U12: 100n; C_1206_3216Metric
D1: SMBJ33A; D_SMB
D2, D3, D4: SS34; D_SMB
D5, D6: BAV99; SOT-23
D13, D14, D15, D16, D17, D18, D19, D20: SMBJ24CA; D_SMB
D_IN0, D_IN1, D_IN2, D_IN3, D_IN4, D_IN5, D_IN6, D_IN7: IN4148W; D_SOD-123
D_TVS0, D_TVS1, D_TVS2, D_TVS3, D_TVS4, D_TVS5, D_TVS6, D_TVS7: SMBJ16A; D_SMA
F1: MF-MSMF110; Fuse_1210_3225Metric
J1, J2: JST_SH_1x04_1.0; JST_SH_BM04B-SRSS-TB_1x04-1MP_P1.00mm_Vertical
J3, J6: 01x08 5.08 pitch horizontal screw terminal; TerminalBlock_Phoenix_MKDS-1,5-8-5.08_1x08_P5.08mm_Horizont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
J4, J5, J7: 01x02 5.08 pitch horizontal screw terminal; TerminalBlock_Phoenix_MKDS-3-2-5.08_1x02_P5.08mm_Horizontal
JP1: SDA PU; SolderJumper-2_P1.3mm_Open_Pad1.0x1.5mm
JP2: SCL PU; SolderJumper-2_P1.3mm_Open_Pad1.0x1.5mm
JP3: IO Add2; SolderJumper-2_P1.3mm_Bridged2Bar_Pad1.0x1.5mm
JP4: IO Add1; SolderJumper-2_P1.3mm_Bridged2Bar_Pad1.0x1.5mm
JP5: IO Add0; SolderJumper-2_P1.3mm_Open_Pad1.0x1.5mm
JP6: AD Add; SolderJumper-2_P1.3mm_Bridged2Bar_Pad1.0x1.5mm
JP7: MAG Add; SolderJumper-2_P1.3mm_Bridged2Bar_Pad1.0x1.5mm
JP8: THERM Add; SolderJumper-2_P1.3mm_Bridged2Bar_Pad1.0x1.5mm
J_MAP1: 01x03 5.08 pitch horizontal screw terminal; TerminalBlock_Phoenix_MKDS-3-3-5.08_1x03_P5.08mm_Horizontal
L1, L2: SRN6045-330M; L_6.3x6.3_H3
Q1, Q2, Q3, Q4, Q5, Q6, Q7, Q8: AOZ1304N; SOT-23
R1, R2, R3, R4, R5, R6, R7, R8: 10K; R_0805_2012Metric
R9, R11, R13, R15, R17, R19, R21, R23: 100R; R_0805_2012Metric
R10, R12, R14, R16, R18, R20, R22, R24: 100K; R_0805_2012Metric
R25: 1M; R_1206_3216Metric
R26: 47K; R_1206_3216Metric
R27: 330K; R_1206_3216Metric
R28: 33K; R_1206_3216Metric
R_IN0, R_IN1, R_IN2, R_IN3, R_IN4, R_IN5, R_IN6, R_IN7: 2K2; R_1206_3216Metric
R_PULL0, R_PULL1, R_PULL2, R_PULL3, R_PULL4, R_PULL5, R_PULL6, R_PULL7: 10K; R_1206_3216Metric
R_SCL1: 4K7; R_0805_2012Metric
R_SDA1: 4K7; R_0805_2012Metric
U1: MCP23017_SO; SOIC-28W_7.5x17.9mm_P1.27mm
U2: ADS1115IDGS; TSSOP-10_3x3mm_P0.5mm
U3: LIS3MDL; LGA-12_2x2mm_P0.5mm
U4, U5, U6, U7, U8, U9, U10, U11: EL817S1(C); SO-4_4.4x3.6mm_P2.54mm
U12: MCP9600-I_MX; QFN65P500X500X100-21N
U13: LM2596S-5; TO-263-5_TabPin3
U14: LM2596S-3.3; TO-263-5_TabPin3

Connections:
3V3_I2C: J1.2, J2.2
+3.3V: 3V3.1, C_3V3.1, C_U1.1, C_U2.1, C_U3.1, C_U12.1, D5.2 (A), D6.2 (A), L2.2, R1.1, R2.1, R3.1, R4.1, R5.1, R6.1, R7.1, R8.1, R_PULL0.1, R_PULL1.1, R_PULL2.1, R_PULL3.1, R_PULL4.1, R_PULL5.1, R_PULL6.1, R_PULL7.1, R_SCL1.1, R_SDA1.1, U1.9 (VDD), U1.18 (~RESET), U2.8 (VDD), U3.5 (Vdd), U3.10 (~CS), U12.8 (VDD), U14.4 (FB)
+12V: F1.1, J5.1
ADC_MAP: C2.1, D6.3 (K), R26.2, R28.1, U2.4 (AIN0)
GND: C1.2, C2.2, C_3V3.2, C_5V1.2, C_12V1.2, C_12V2.2, C_U1.2, C_U2.2, C_U3.2, C_U12.2, D1.2 (A), D3.2 (A), D4.2 (A), D5.1 (K), D6.1 (K), D13.2 (A2), D14.2 (A2), D15.2 (A2), D16.2 (A2), D17.2 (A2), D18.2 (A2), D19.2 (A2), D20.2 (A2), D_IN0.2 (A), D_IN1.2 (A), D_IN2.2 (A), D_IN3.2 (A), D_IN4.2 (A), D_IN5.2 (A), D_IN6.2 (A), D_IN7.2 (A), D_TVS0.2 (A2), D_TVS1.2 (A2), D_TVS2.2 (A2), D_TVS3.2 (A2), D_TVS4.2 (A2), D_TVS5.2 (A2), D_TVS6.2 (A2), D_TVS7.2 (A2), J1.1, J1.MP (MountPin), J2.1, J2.MP (MountPin), J5.2, J7.2, JP3.1 (A), JP4.1 (A), JP5.1 (A), JP6.2 (B), JP7.2 (B), JP8.2 (B), J_MAP1.3, Q1.2 (S), Q2.2 (S), Q3.2 (S), Q4.2 (S), Q5.2 (S), Q6.2 (S), Q7.2 (S), Q8.2 (S), R10.2, R12.2, R14.2, R16.2, R18.2, R20.2, R22.2, R24.2, R27.2, R28.2, U1.10 (VSS), U2.3 (GND), U3.2 (GND), U3.3 (GND), U3.12 (GND), U4.2, U4.3, U5.2, U5.3, U6.2, U6.3, U7.2, U7.3, U8.2, U8.3, U9.2, U9.3, U10.2, U10.3, U11.2, U11.3, U12.1 (GND), U12.3 (GND), U12.5 (GND), U12.6 (GND), U12.7 (GND), U12.9 (GND), U12.10 (GND), U12.13 (GND), U12.17 (GND), U12.18 (GND), U12.21 (EXP), U12.22 (EXP), U12.23 (EXP), U12.24 (EXP), U12.25 (EXP), U12.26 (EXP), U12.27 (EXP), U12.28 (EXP), U12.29 (EXP), U12.30 (EXP), U13.3 (GND), U13.5 (~ON/OFF), U14.3 (GND), U14.5 (~ON/OFF)
IN0: D_TVS0.1 (A1), J3.1, R_IN0.2
IN1: D_TVS1.1 (A1), J3.2, R_IN1.2
IN2: D_TVS2.1 (A1), J3.3, R_IN2.2
IN3: D_TVS3.1 (A1), J3.4, R_IN3.2
IN4: D_TVS4.1 (A1), J3.5, R_IN4.2
IN5: D_TVS5.1 (A1), J3.6, R_IN5.2
IN6: D_TVS6.1 (A1), J3.7, R_IN6.2
IN7: D_TVS7.1 (A1), J3.8, R_IN7.2
MAP_5V: 5V.1, C_5V1.1, J_MAP1.1, L1.2, U13.4 (FB)
MAP_SIG: J_MAP1.2, R26.1
unnamed: D1.1 (K), D2.2 (A), F1.2
unnamed: D3.1 (K), L1.1, U13.2 (OUT)
unnamed: D4.1 (K), L2.1, U14.2 (OUT)
unnamed: D_IN0.1 (K), R_IN0.1, U4.1
unnamed: D_IN1.1 (K), R_IN1.1, U5.1
unnamed: D_IN2.1 (K), R_IN2.1, U6.1
unnamed: D_IN3.1 (K), R_IN3.1, U7.1
unnamed: D_IN4.1 (K), R_IN4.1, U8.1
unnamed: D_IN5.1 (K), R_IN5.1, U9.1
unnamed: D_IN6.1 (K), R_IN6.1, U10.1
unnamed: D_IN7.1 (K), R_IN7.1, U11.1
unnamed: JP1.2 (B), R_SDA1.2
unnamed: JP2.2 (B), R_SCL1.2
unnamed: JP3.2 (B), R3.2, U1.17 (A2)
unnamed: JP4.2 (B), R2.2, U1.16 (A1)
unnamed: JP5.2 (B), R1.2, U1.15 (A0)
unnamed: JP6.1 (A), R4.2, U2.1 (ADDR)
unnamed: JP7.1 (A), R5.2, U3.9 (SDO/SA1)
unnamed: JP8.1 (A), R6.2, U12.16 (ADDR)
unnamed: Q1.1 (G), R9.2, R10.1
unnamed: Q2.1 (G), R11.2, R12.1
unnamed: Q3.1 (G), R13.2, R14.1
unnamed: Q4.1 (G), R15.2, R16.1
unnamed: Q5.1 (G), R17.2, R18.1
unnamed: Q6.1 (G), R19.2, R20.1
unnamed: Q7.1 (G), R21.2, R22.1
unnamed: Q8.1 (G), R23.2, R24.1
unnamed: R9.1, U1.21 (GPA0)
unnamed: R11.1, U1.22 (GPA1)
unnamed: R13.1, U1.23 (GPA2)
unnamed: R15.1, U1.24 (GPA3)
unnamed: R17.1, U1.25 (GPA4)
unnamed: R19.1, U1.26 (GPA5)
unnamed: R21.1, U1.27 (GPA6)
unnamed: R23.1, U1.28 (GPA7)
unnamed: R_PULL0.2, U1.1 (GPB0), U4.4
unnamed: R_PULL1.2, U1.2 (GPB1), U5.4
unnamed: R_PULL2.2, U1.3 (GPB2), U6.4
unnamed: R_PULL3.2, U1.4 (GPB3), U7.4
unnamed: R_PULL4.2, U1.5 (GPB4), U8.4
unnamed: R_PULL5.2, U1.6 (GPB5), U9.4
unnamed: R_PULL6.2, U1.7 (GPB6), U10.4
unnamed: R_PULL7.2, U1.8 (GPB7), U11.4
unnamed: R7.2, U1.20 (INTA), U12.11 (ALERT_1)
unnamed: R8.2, U1.19 (INTB), U12.12 (ALERT_2)
unnamed: C1.1, D5.3 (K), R25.2, R27.1, U2.5 (AIN1)
PROTO_12V: C_12V1.1, C_12V2.1, D2.1 (K), U13.1 (VIN), U14.1 (VIN)
RL0: D13.1 (A1), J6.1, Q1.3 (D)
RL1: D14.1 (A1), J6.2, Q2.3 (D)
RL2: D15.1 (A1), J6.3, Q3.3 (D)
RL3: D16.1 (A1), J6.4, Q4.3 (D)
RL4: D17.1 (A1), J6.5, Q5.3 (D)
RL5: D18.1 (A1), J6.6, Q6.3 (D)
RL6: D19.1 (A1), J6.7, Q7.3 (D)
RL7: D20.1 (A1), J6.8, Q8.3 (D)
SCL: J1.4, J2.4, JP2.1 (A), U1.12 (SCK), U2.10 (SCL), U3.1 (SCL/SPC), U12.19 (SCL)
SDA: J1.3, J2.3, JP1.1 (A), U1.13 (SDA), U2.9 (SDA), U3.11 (SDA/SDI/SDO), U12.20 (SDA)
TC+: J4.1, U12.2 (VIN+)
TC-: J4.2, U12.4 (VIN-)
TEMP_SIG: J7.1, R25.1
