paulrbarnard/LandyGauge/static/downloads/pcb-fan-relay/LandyFan.kicad_pcb

## KiCad design static/downloads/pcb-fan-relay/LandyFan.kicad_pcb (2026-04-20)

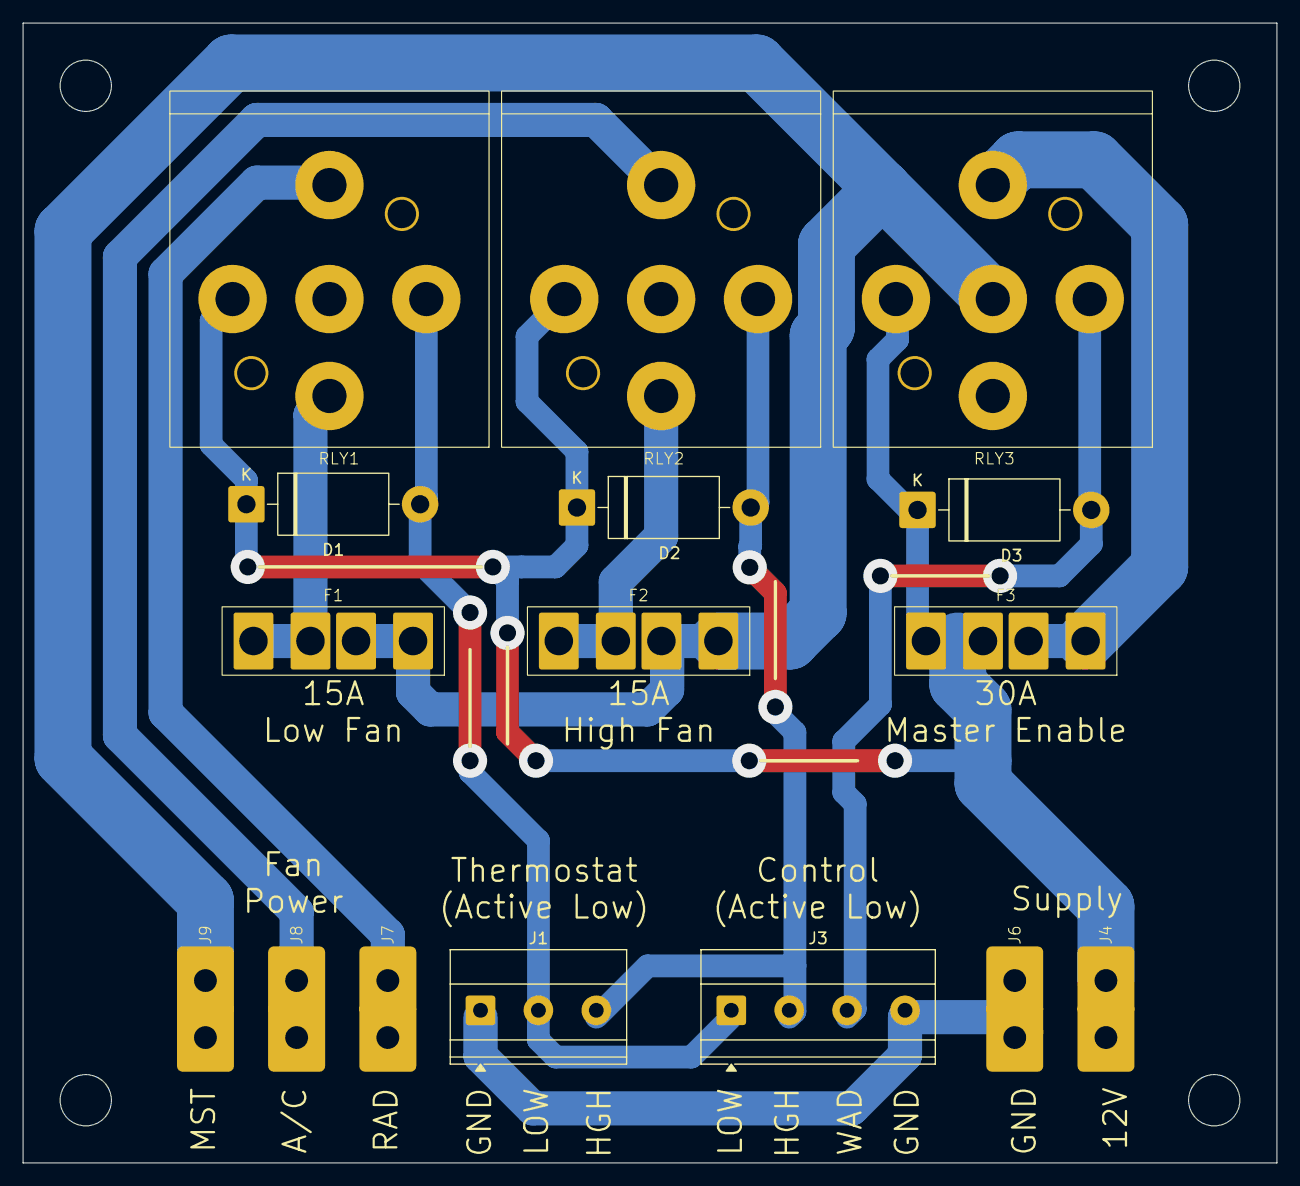
[picture p48: board LandyFan.kicad_pcb from above]

Board: 2 copper layers, 110.0 x 100.0 mm, 16 parts (0 on the bottom side), 11 nets.

Parts:
D1, D2, D3: 1N5408; D_DO-201AD_P15.24mm_Horizontal
F1, F2: 15A; FuseHolder_Switch_Electronics
F3: 30A; FuseHolder_Switch_Electronics
J1: Thermal Switch; TerminalBlock_Phoenix_MKDS-1,5-3-5.08_1x03_P5.08mm_Horizont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
J3: Control; TerminalBlock_Phoenix_MKDS-1,5-4-5.08_1x04_P5.08mm_Horizont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
J4, J6, J7, J8, J9: Conn_01x01_Pin; FASTON .250 Spade
RLY1, RLY2, RLY3: Bosch Automotive Relay

Connections:
+12V: D1.1 (K), D2.1 (K), D3.1 (K), F3.2, J4.1, RLY1.85, RLY2.85, RLY3.85
GND: J1.1, J3.4, J6.1
HighFanEnable: D2.2 (A), J1.3, J3.2, RLY2.86
HighFanSupply: J8.1, RLY2.30
LowFanEnable: D1.2 (A), J1.2, J3.1, RLY1.86
LowFanSupply: J7.1, RLY1.30
MasterFanEnable: F1.1, F2.1, J9.1, RLY3.87a
unnamed: F1.2, RLY1.87
unnamed: F2.2, RLY2.87
unnamed: F3.1, RLY3.30
WaddingEnable: D3.2 (A), J3.3, RLY3.86
