paulrbarnard/LandyGauge/(commit log)

2026-04-20 Switch domain to toxiccelery.com
2026-04-20 Add PCB schematics, 3D models, and wiring downloads
    - Gauge supply PCB (KiCad + gerbers + STEP)
    - Expansion board PCB (KiCad + gerbers + STEP + PDF)
    - Fan relay PCB (KiCad + gerbers + STEP)
    - Wiring schematic (KiCad + PDF)
    - 3D models: case, cover, bezels, nut, button plug (OBJ + Fusion 360)
    - Hardware page updated with download tables
    [Bezel - Non Touch.obj, Bezel - Touch.obj, ButtonPlug.obj, Case.obj, Cover.obj, GaugeSupply.kicad_pcb, GaugeSupply.kicad_sch, GaugeSupply.step]
2026-04-20 Update gauge supply gerbers (renamed to gerbers.zip)
2026-04-20 Replace expansion board gerbers with updated gerbers.zip
2026-04-21 Remove duplicate wiring schematic file
2026-04-22 Update homepage, hardware content, and 3D model downloads
    [Base.obj, Bezel - Non Touch.obj, Bezel - Touch.obj, BoardClamp.obj, ButtonPlug.obj, CableClamp.obj, Case.obj, Cover.obj]
2026-04-22 Update build guide, hardware docs, and connector images
